RockeyyAbraham/Paaniguard/README.md

# PaaniGuard

ESP8266-based IoT water quality and usage monitoring system. Board target:
`esp8266:esp8266:nodemcuv2`. This firmware was built and compile-verified
with **no physical ESP8266 board attached** — see "What's stubbed pending
real hardware" and "Running without a board" below.

## File structure

| File | Purpose |
|---|---|
| `PaaniGuard.ino` | `setup()`/`loop()` only — wires the modules below together, no logic of its own |
| `config.h` | All pin definitions, WiFi placeholder credentials, thresholds, calibration constants |
| `sensors.h` / `.cpp` | Raw reads: pH & TDS (via ADS1115), DS18B20 temperature, flow pulse counting (ISR) |
| `drift_compensation.h` / `.cpp` | TDS temperature compensation + rolling-baseline drift correction, checkpoint persistence |
| `fingerprinting.h` / `.cpp` | Rule-based (non-ML) contamination pattern table and alert strings |
| `actuators.h` / `.cpp` | Relay/solenoid, buzzer, WS2812B status LED |
| `display.h` / `.cpp` | SSD1306 OLED rendering |
| `connectivity.h` / `.cpp` | WiFi station connect + SoftAP fallback |
| `webserver.h` / `.cpp` | Local status webpage (readings + active alert) |
| `cloud_logging.h` / `.cpp` | ThingSpeak push |
| `storage.h` / `.cpp` | LittleFS ring buffer of readings, survives reboot |
| `simulation.h` / `.cpp` | Synthetic sensor data for `SIMULATION_MODE` |
| `libraries.txt` | Libraries used by the production firmware |
| `wokwi/` | Experimental ESP32 target; production ESP8266 code is unchanged |

The production files live directly in this repo root because it is the Arduino
sketch folder itself (the `.ino` and its folder must share the containing
folder's name for the Arduino IDE to recognize it). `host_sim/` is a separate
native test harness, and `wokwi/` is a separate ESP32 experiment.

The older monolithic sketch is retained under `legacy/test.ino` so it remains
available for reference without being compiled as a second sketch. The former
root-level ESP32 Wokwi metadata is retained as
`legacy/experimental-root-diagram.json` and
`legacy/experimental-root-wokwi.toml`.
The production modules stay at the sketch root because Arduino IDE/CLI
compiles the root `.cpp` files automatically; moving them into `src/` would
require a different build layout and could break the existing Arduino flow.

The browser-based logic simulator lives in `virtual-simulation/`. It is a
separate software validation environment that mirrors source-defined behavior
without executing the ESP8266 firmware or claiming electrical validation. Open
`virtual-simulation/index.html` directly, or serve that folder with a static
HTTP server as described in its README.

## Pin map

Pins aren't locked to real hardware yet — this is a proposal, documented
here so it can be revisited once the board is on the bench.

| Signal | NodeMCU pin | GPIO | Why this pin |
|---|---|---|---|
| I2C SCL (ADS1115 + OLED) | D1 | GPIO5 | Standard ESP8266 Arduino core `Wire` default SCL |
| I2C SDA (ADS1115 + OLED) | D2 | GPIO4 | Standard ESP8266 Arduino core `Wire` default SDA |
| DS18B20 OneWire data | D6 | GPIO12 | No boot-time role; safe as a plain I/O from power-up |
| YF-S201 flow pulse (interrupt) | D5 | GPIO14 | Interrupt-capable and boot-safe; pulses can arrive before WiFi/cloud logic is up |
| Relay (solenoid valve) | D7 | GPIO13 | Plain output, no boot-time role; opto-isolation on the relay board protects the GPIO |
| WS2812B status LED data | D4 | GPIO2 | Requires HIGH at boot; its internal pull-up keeps it HIGH through boot since nothing writes to it until `setup()` runs |
| Buzzer | D0 | GPIO16 | No pull-up/interrupt support and normally reserved for deep-sleep wake (unused here); only ever written after `setup()` |
| *(unused, reserved)* | D3 | GPIO0 | Boot-sensitive (must read HIGH at boot) — left disconnected rather than risked |
| *(unused, reserved)* | D8 | GPIO15 | Boot-sensitive (must read LOW at boot) — left disconnected rather than risked |
| *(reserved)* | RX/TX | GPIO3/GPIO1 | Kept free for `Serial` — used for all debug/`SIMULATION_MODE` logging |
| *(intentionally unused)* | A0 | — | ESP8266's one onboard analog pin, only 10-bit — exactly why the ADS1115 is used instead (see below) |

**Why ADS1115 is mandatory:** the ESP8266 has exactly one analog input, at
10-bit resolution — not enough channels or precision for both pH and TDS.
The ADS1115 gives 4 channels at 16-bit over I2C, so pH is on ADS channel 0
and TDS is on ADS channel 1 (see `config.h`), with two channels spare.

## Libraries required

Install via `arduino-cli lib install`:

- Adafruit ADS1X15
- OneWire
- DallasTemperature
- Adafruit SSD1306
- Adafruit GFX Library
- Adafruit NeoPixel
- ThingSpeak
- (bundled with the `esp8266:esp8266` core: `ESP8266WiFi`, `ESP8266WebServer`, `LittleFS`)

**Cloud service: ThingSpeak**, not Blynk — a plain REST field-write needs no
persistent connection or companion app, and comfortably fits a
single-channel hobby/bench deployment. See `cloud_logging.cpp`.

## Opening / building this project

**Arduino IDE:** open `PaaniGuard.ino` directly. Install the ESP8266 board
package (board manager URL
`https://arduino.esp8266.com/stable/package_esp8266com_index.json`) and the
libraries above, then select board "NodeMCU 1.0 (ESP-12E Module)".

**arduino-cli**, run from the repo root:

```
arduino-cli config init
arduino-cli config add board_manager.additional_urls https://arduino.esp8266.com/stable/package_esp8266com_index.json
arduino-cli core update-index
arduino-cli core install esp8266:esp8266
arduino-cli lib install "Adafruit ADS1X15" "OneWire" "DallasTemperature" "Adafruit SSD1306" "Adafruit GFX Library" "Adafruit NeoPixel" "ThingSpeak"
arduino-cli compile --fqbn esp8266:esp8266:nodemcuv2 .
```

## Wokwi limitation

The production firmware is ESP8266-specific and remains unchanged. The
installed Wokwi VS Code extension (3.7.0) does not provide a usable
`wokwi-nodemcu-v2` or ESP8266 board model for `diagram.json`; the extension's
ESP8266 reference is for upload/debug tooling, not a Wokwi virtual board.
Therefore an exact Wokwi simulation of the production ESP8266 firmware is not
available in this environment. Do not treat an ESP32 diagram as an ESP8266
simulation and do not flash the ESP32 sketch to ESP8266 hardware.

The existing `wokwi/` directory is retained as a separate ESP32 compatibility
experiment only. It is not the production firmware, does not validate
ESP8266-specific behavior, and must not be used as evidence that the physical
ESP8266 build works. It preserves the production project's logical GPIO
numbers only to exercise generic peripheral behavior:

| Function | Production ESP8266 | Wokwi ESP32 GPIO |
|---|---|---:|
| DS18B20 | D6 / GPIO12 | GPIO12 |
| Flow pulse | D5 / GPIO14 | GPIO14 |
| Relay | D7 / GPIO13 | GPIO13 |
| WS2812B | D4 / GPIO2 | GPIO2 |
| Buzzer | D0 / GPIO16 | GPIO16 |
| OLED SDA | D2 / GPIO4 | GPIO4 |
| OLED SCL | D1 / GPIO5 | GPIO5 |

The compatibility experiment exercises generic DS18B20, flow input, relay,
buzzer, WS2812B, OLED, WiFi status page, drift compensation, and alert
behavior. TDS and pH remain simulated. It does not execute the root
`Paaniguard.ino` or its ESP8266 modules.

Install the ESP32 Arduino core once:

```
arduino-cli core install esp32:esp32
```

Build the virtual firmware artifact used by `wokwi/wokwi.toml` from the
repository root:

```
arduino-cli compile --fqbn esp32:esp32:esp32 --build-path wokwi/build --export-binaries wokwi
```

To run that compatibility experiment, open the `wokwi/` folder as the VS Code
workspace, open its `diagram.json`, and start Wokwi. This is optional and is
not a substitute for compiling and bench-testing the ESP8266 firmware. See
`wokwi/README.md` for the separation and exact commands.

For the real target, compile the root project with the ESP8266 board package,
then verify the physical wiring against the pin table above. The flow
pushbutton in the compatibility experiment is only a simulation substitute;
the physical device requires the flow sensor output to be divided down or
level-shifted before it reaches a GPIO — see "Electrical build notes" below.
An open-collector pull-up alone is not sufficient.

### Electrical build notes

See `BUILD.md` for the full step-by-step wiring sequence with test gates.

- The DS18B20 data line has the required 4.7 kOhm pull-up to 3.3 V.
- The physical YF-S201 flow output must never drive an ESP8266/ESP32 GPIO
  above 3.3 V. The YF-S201 needs 4.5 V minimum, so running it at 3.3 V to
  dodge the problem is out of spec and not an option. Power it from 5 V and
  drop the yellow signal line with a resistive divider: 1.8 kOhm in series
  from the sensor signal, then 3.3 kOhm from that junction to GND, with the
  junction going to GPIO14/D5. That gives ~3.24 V. A 10 kOhm / 20 kOhm pair
  also lands in range (3.33 V) but is higher impedance and gives a slower
  pulse edge. A dedicated level shifter is also valid. An external pull-up
  alone does NOT work: the sensor's own PCB already pulls the open-collector
  hall output up to its VCC rail, so the node still sits near 5 V (~3.7 V or
  more) and the GPIO still sees an over-voltage.
- The common 1-channel opto-isolated relay module is typically ACTIVE-LOW
  (IN pulled LOW energises the coil), which is the opposite of the
  active-HIGH assumption the firmware currently ships with. Measure the
  polarity on the actual board with a multimeter before the solenoid is
  plumbed (`BUILD.md`, BAG 6, Step 18). If it is active-LOW, swap
  `RELAY_LEVEL_VALVE_OPEN` and `RELAY_LEVEL_VALVE_CLOSED` in `config.h` —
  the drive levels are isolated there specifically so a polarity flip is a
  one-line change and never requires editing `actuators.cpp`.
- Feed the relay module's logic-side VCC from 3.3 V, not 5 V. At 5 V the IN
  pin becomes a 5 V node that a 3.3 V GPIO cannot drive cleanly, and it
  floats toward 4 V while the GPIO is high-impedance during boot/reset,
  back-feeding a pin that is not 5 V tolerant. If the board has a JD-VCC
  jumper, remove it and feed JD-VCC from 5 V so the coil still gets its
  rated voltage.
- The virtual relay module is only a logic simulation. For the physical
  solenoid, use a separately rated supply, an appropriately rated relay or
  MOSFET driver, a fuse, and flyback suppression. Do not power a 12 V valve
  from the microcontroller 3.3 V rail.
- Keep sensor/logic ground common at the controller. The physical relay's
  high-voltage or 12 V load wiring must remain isolated from the GPIO side.

**Re-verification pending.** The figures below were measured before the
drift-confidence API, the valve latch, and the WiFi reconnect path were added.
Those changes have not been compiled against the ESP8266 toolchain yet, because
`arduino-cli` is not installed in the environment they were written in. Re-run
the compile command above and update this paragraph with the real numbers
before citing them.

What *has* been verified since those changes: `host_sim` compiles the real
`drift_compensation.cpp` and `fingerprinting.cpp` with `g++ -Wall -Wextra` at
0 warnings, and its 7 assertions pass (see "Running without a board" below).
That covers the drift and fingerprinting logic only — not `actuators.cpp`,
`connectivity.cpp`, or the sketch itself.

Previously measured: 0 errors, 0 warnings in any PaaniGuard file, with
`--warnings all`. (The bundled ThingSpeak library itself emits 2 unused-
parameter warnings from its own header — not this project's code — when
`--warnings all` is used.) Flash size ~323KB/1MB (31%), IRAM ~61KB/65KB
(93%, mostly the ESP8266 core's own reserved instruction cache).

## Running without a board

No ESP8266 is attached to this project yet, so two separate things stand in
for "flash it and watch Serial":

**1. `SIMULATION_MODE` in the actual firmware.** `config.h` has
`#define SIMULATION_MODE 1`. With it on, `sensors.cpp` calls
`simulation.cpp` instead of touching real hardware, cycling through four
scenarios (6 sensor-read ticks each, ~30s at the default 5s interval):
clean water, a backdated rolling-baseline drift check, and two
contamination fingerprints (pH-drop+TDS-spike, and TDS-severe-alone). Every
tick prints one Serial line with pH, raw TDS, corrected TDS, temperature,
flow, and the fingerprinting decision (severity + shutoff y/n). This is
real firmware code and compiles/would run exactly this way once flashed —
it just can't be captured here without a board plugged in.

**2. `host_sim/` — a native test harness for right now.** Since there's no
board to flash, `host_sim/` compiles the *actual, unmodified*
`drift_compensation.cpp` and `fingerprinting.cpp` against two tiny
stand-in headers (`Arduino.h`, `LittleFS.h` — just enough surface for
`Serial`, `millis()`, and an in-memory LittleFS) and runs the same four
scenarios as a plain Windows executable, so the drift-correction and
fingerprinting logic can be inspected today. Build and run it with:

```
cd host_sim
g++ -std=gnu++14 -I. main.cpp shim_globals.cpp ../drift_compensation.cpp ../fingerprinting.cpp -o paaniguard_sim.exe
./paaniguard_sim.exe
```

Sample output (captured from this exact build):

```
=== Scenario 1: normal/clean water sample ===
[clean@25C       ] pH= 7.00  rawTDS=  310.0  tempC=25.0  ->  tempCompTDS=  310.0  ->  baselineCorrectedTDS=  310.0
                     severity=NONE     shutoff=no  alert="Water quality within normal parameters."
[clean@30C       ] pH= 7.00  rawTDS=  310.0  tempC=30.0  ->  tempCompTDS=  281.8  ->  baselineCorrectedTDS=  281.8
                     severity=NONE     shutoff=no  alert="Water quality within normal parameters."

=== Scenario 2: rolling-baseline drift correction ===
recording 4 backdated calibration checkpoints (probe dipped in 342ppm reference), simulating a week of fouling drift:
drift_compensation: recorded checkpoint day=20697 measuredPpm=345.00
drift_compensation: recorded checkpoint day=20699 measuredPpm=351.00
drift_compensation: recorded checkpoint day=20701 measuredPpm=358.00
drift_compensation: recorded checkpoint day=20703 measuredPpm=364.00
[post-drift-fit  ] pH= 7.00  rawTDS=  310.0  tempC=25.0  ->  tempCompTDS=  310.0  ->  baselineCorrectedTDS=  287.9
                     severity=NONE     shutoff=no  alert="Water quality within normal parameters."

=== Scenario 3: contamination pattern A (pH drop + TDS spike) ===
[contam-A        ] pH= 5.00  rawTDS= 1100.0  tempC=25.0  ->  tempCompTDS= 1100.0  ->  baselineCorrectedTDS= 1077.9
                     severity=SEVERE   shutoff=YES alert="Combined pH drop/spike with elevated TDS detected. Strong signature of chemical or industrial contamination. Water supply automatically shut off as a precaution."

=== Scenario 4: contamination pattern B (TDS severe spike alone, pH normal) ===
[contam-B        ] pH= 7.00  rawTDS= 1200.0  tempC=25.0  ->  tempCompTDS= 1200.0  ->  baselineCorrectedTDS= 1177.9
                     severity=SEVERE   shutoff=YES alert="Severe TDS spike detected, independent of pH. Possible heavy contamination event (e.g. industrial discharge, saltwater intrusion). Water supply automatically shut off as a precaution."
```

What this demonstrates:
- **Temperature compensation** (mechanism 1): `clean@30C` shows the same
  310ppm raw reading normalized down to 281.8ppm at a warmer temperature —
  the ~2%/°C rule in `drift_applyTemperatureCompensation()`.
- **Rolling-baseline drift correction** (mechanism 2, distinct from the
  above): after 4 backdated checkpoints showing the probe reading
  progressively higher than the 342ppm reference, the *same* 310ppm raw
  input that scenario 1 called "310.0, no correction" is now corrected down
  to 287.9ppm — `drift_applyBaselineCorrection()`'s linear fit predicting
  and subtracting the accumulated drift.
- **Fingerprinting**: two distinct SEVERE patterns (pH+TDS combined, and
  TDS alone) both correctly trigger `shutoff=YES` with their own
  pre-written alert text, while the clean and drift scenarios correctly
  stay at `NONE`.

`host_sim/` is a verification aid only — it is not compiled or referenced
by the actual sketch, and arduino-cli never sees it.

## What's stubbed pending real hardware

Every value below is a **PLACEHOLDER** (also marked `// PLACEHOLDER` /
`// TODO` at its definition in `config.h`) and must be replaced once the
real sensors and board are on the bench:

- **WiFi credentials** (`WIFI_SSID`, `WIFI_PASSWORD`) — dummy values.
- **ThingSpeak channel/key** (`THINGSPEAK_CHANNEL_ID`, `THINGSPEAK_WRITE_API_KEY`).
- **pH calibration** (`PH_CALIBRATION_SLOPE`, `PH_CALIBRATION_OFFSET`) —
  must be derived from real readings in pH 4.0 and 7.0 buffer solutions.
- **TDS calibration** (`TDS_CAL_COEFF_A/B/C`, `TDS_VREF`) — must be
  re-fit against the 342ppm reference solution on the real ADS1115 + TDS
  module; current values are textbook-typical starting points only.
- **Flow sensor pulses-per-liter** (`FLOW_PULSES_PER_LITER`) —
  datasheet-typical for the YF-S201, must be bench-measured with a
  known-volume container (unit-to-unit variance is common).
- **Safety thresholds** (`PH_SAFE_MIN/MAX`, `PH_SEVERE_LOW/HIGH`,
  `TDS_SAFE_MAX_PPM`, `TDS_SEVERE_MAX_PPM`) — WHO-typical starting points,
  not tuned to any specific local water supply.
- **Local authority contact** (`LOCAL_AUTHORITY_CONTACT`) — placeholder
  text only; the firmware never auto-dials or auto-texts anyone regardless
  of what this string says.
- **SSD1306/ADS1115 I2C addresses** — common defaults, confirm once the
  actual modules are wired up (some SSD1306 boards ship at `0x3D`).

## Design notes worth knowing about

- **Valve fail-safe:** `PIN_RELAY_VALVE` defaults LOW at boot (relay
  de-energized, valve closed) and only opens when explicitly commanded — an
  unexpected reset never leaves water flowing unsupervised.
- **Offline-first safety:** `fingerprint_evaluate()` and
  `actuators_applyFingerprint()` never touch the network — the shutoff/
  buzzer/LED response is identical whether WiFi is connected, in SoftAP
  fallback, or fully offline.
- **No RTC:** `drift_getCurrentDayIndex()` uses NTP epoch time once online
  (synced opportunistically by `connectivity.cpp`), and falls back to a
  flash-persisted uptime-based day counter when offline. Any power-off
  downtime is treated as instantaneous in that fallback — a known,
  documented approximation until/unless a real RTC is added.
- **Storage never blocks or fails:** `storage.cpp`'s ring buffer is
  preallocated on first boot; every append overwrites one fixed slot, so
  there's no filesystem growth and no "disk full" failure mode.
