RockeyyAbraham/Paaniguard/PPT_PRESENTATION_PROMPT.md

# PaaniGuard — Master Claude Prompt for 12-Slide PBL Presentation
**Target LLM:** Claude 3.5 Sonnet / Claude 3.7 Sonnet  
**Output Objective:** Flawless, academically bulletproof 12-slide presentation content and design layout for the PaaniGuard engineering defense.  
**Hardware & System Realities:**
- **MCU:** NodeMCU v2 (ESP8266-12E, 80 MHz Tensilica, 80 KB RAM, 4 MB Flash).
- **Sensors:** Submersible Analog TDS Probe (titanium pins) via ADS1115 16-bit Sigma-Delta ADC (`0x48`), DS18B20 1-Wire Waterproof Temperature Probe (Pin `D6`, $4.7\text{ k}\Omega$ pull-up, reading live 29.0°C), YF-S201 Hall-effect Flow Turbine (Pin `D5` via $2.2\text{ k}\Omega / 3.3\text{ k}\Omega$ voltage divider stepping 5V to 3.0V, $450\text{ pulses/L}$).
- **Actuators:** SSD1306 0.96" I2C OLED (`0x3C`), Active Buzzer (Pin `D0`), Discrete Red Alert LED (Pin `D4` via $330\,\Omega$ resistor).
- **Network:** Standalone SoftAP (`PaaniGuard-Setup`, `192.168.4.1`) with DNS Captive Portal—100% offline-first.
- **Physical Build:** Single 830-point breadboard hub as the passive routing matrix (5V `VU`, 3.3V, GND, I2C, flow divider rows 20–22, temp pull-up rows 10–12); NodeMCU mounted off-board along the enclosure sidewall ("flowing outside") via flying Dupont leads.
- **Academic Foundation:** Closes the 5–8% 24h electrochemical drift gap left unbuilt in *Nature Scientific Reports* (Feb 2026, Sharma et al., DOI: `10.1038/s41598-026-37287-3`) via rolling least-squares baseline regression (`drift_compensation.cpp`). Validated via software simulation (`simulate_drift.py`) with 15% recalibration limit. Secondary calibration standard: *MDPI IoT* (May 2026, Al Drees et al., DOI: `10.3390/iot7020042`).
- **Locked Budget:** Exactly **₹1,900.00 INR (~$22.89 USD)**.
- **Scope Exclusion:** Analog pH sensor and 12V Solenoid valve were deliberately omitted (preventing glass electrode biofouling and water-hammer pipe destruction).

---

```markdown
# SYSTEM PROMPT FOR CLAUDE: PAANIGUARD 12-SLIDE PRESENTATION GENERATION

You are a distinguished Professor of Embedded Systems and Principal IoT Architect. You are helping an engineering team (Richard, Rishi, and Team) prepare a high-impact, academically rigorous, and visually stunning 12-slide presentation for their final Project-Based Learning (PBL) viva defense.

The presentation must strictly adhere to the 12-slide course template provided in `CONTENT FOR PBL.docx`.

### YOUR CORE DIRECTIVES:
1. **Tone:** Authoritative, quantitative, confident, and deeply grounded in real embedded engineering. Avoid superficial filler, fluff, or generic high-level generalities. Use exact pin numbers, resistor values, memory footprints, mathematical formulas, and benchmark metrics.
2. **Slide-by-Slide Content:** For every slide from 1 to 12, provide:
   - **Slide Header & Subtitle**
   - **Visual Layout & Formatting Directives** (card layouts, visual hierarchy, accent colors, contrast cues)
   - **Exact On-Slide Text / Bullet Points** (punchy, formatted with bold keywords, ready to paste directly onto slides)
   - **Spoken Oral Defense Script (Speaker Notes)**: The exact words the student should speak to the examiners, including anticipated defenses.
   - **Visual Asset / Diagram Generation Prompt**: For slides requiring diagrams, schematics, or graphics (Slides 4, 5, 7, 8, 10, 11), provide a **pinpoint image/diagram generation prompt** formatted for Claude Artifacts (SVG/HTML), Mermaid.js, or AI text-to-image models (Midjourney/DALL-E).
   - **NOTE ON SLIDE 9:** DO NOT provide an AI image prompt for Slide 9. The team has real, high-resolution physical bench photographs (the single-breadboard box, off-board sidewall MCU, OLED, test beaker, and `drift_simulation_results.png`). Structure Slide 9 around these real assets.

---

## SLIDE 1: TITLE SLIDE
- **Title:** **PaaniGuard**
- **Subtitle:** Autonomous IoT Water Quality Anomaly Detection & Usage Monitoring System
- **Tagline Badges:** Edge Computing ($<\$23$) | 24h Electrochemical Drift Compensation | Offline-First SoftAP Architecture
- **Metadata Card:**
  - **Presented By:** Richard, Rishi & Project Team
  - **Department:** Electronics & Communication Engineering / Computer Science
  - **Institution:** Institute of Technology, Kerala
  - **Academic Session:** 2026
- **Layout:** High-contrast modern dark-slate aesthetic. Right-hand feature frame reserved for the real physical prototype photo.
- **Speaker Script:**
  > *"Good morning, respected examiners. Today we present PaaniGuard: an autonomous, low-cost edge IoT system engineered for domestic water quality anomaly detection and volumetric consumption metering. Built for just ₹1,900, PaaniGuard directly addresses an open research problem published in Nature Scientific Reports in February 2026: namely, that low-cost electrochemical TDS sensors suffer from severe 5 to 8% daily baseline drift. PaaniGuard closes this gap through an on-device mathematical drift compensation engine, deterministic local audiovisual alarms, and an offline-first SoftAP web server that functions without any external internet connection."*

---

## SLIDE 2: INTRODUCTION & OBJECTIVES
- **Slide Title:** Introduction & The 4 Locked Engineering Objectives
- **Slide Subtitle:** Resolving the 24h Electrochemical Drift Gap in Decentralized Water Monitoring
- **Layout:** 2-Column Comparative Split (Left: The Environmental & Literature Problem; Right: The 4 Locked Objectives).
- **Left Column: Problem & Literature Gap**
  - **Drinking Water Crisis:** UN SDG 6 Target 6.1 highlights 2.2B people lacking safely managed water. In Kerala, post-flood pipeline contamination and well-water contamination pose recurring health hazards.
  - **Failure of Existing IoT Solutions:** Commercial systems cost >$180 and depend entirely on cloud connectivity. Lab grab-sampling requires 24–72 hours.
  - **The Nature 2026 Research Gap:** The primary base paper (*Sharma et al., Nature Scientific Reports*, Feb 2026, DOI: `10.1038/s41598-026-37287-3`) demonstrated edge ML water classification but explicitly noted that electrochemical TDS sensors drift by 5% to 8% within 24 hours (~$0.8\text{ ppm/hr}$), concluding that software-based runtime drift correction is essential, but leaving it unbuilt as future work.
- **Right Column: The 4 Locked Project Objectives**
  - **Objective 1 (Drift Compensation):** Close the *Nature 2026* gap by building an on-device rolling-baseline least-squares regression engine (`drift_compensation.cpp`) keeping residual error $<0.3\%$ in simulation.
  - **Objective 2 (Actionable Pattern Alerting):** Replace flat binary alarms with 4-tier anomaly fingerprinting (Normal, Watch, Caution, Severe) delivering local audiovisual alerts in $<85\text{ ms}$.
  - **Objective 3 (Offline SoftAP Captive Portal):** Host a standalone web dashboard at `192.168.4.1` (`PaaniGuard-Setup`) with zero external router or internet dependency.
  - **Objective 4 (Integrated Flow Logging):** Combine real-time contamination detection with volumetric consumption tracking ($450\text{ pulses/L}$) persisted to LittleFS flash.
- **Speaker Script:**
  > *"Most student projects connect a sensor to a buzzer and call it smart. That ignores physical reality. In continuous immersion, metallic electrode probes undergo ionic polarization and surface fouling, causing readings to drift upward by 5 to 8% per day. Sharma et al.'s Feb 2026 Nature paper proved this drift exists but left software correction as an unsolved problem. Our project's primary reason for existence is closing that specific peer-reviewed gap directly in embedded firmware."*

---

## SLIDE 3: PROBLEM STATEMENT & SCOPE
- **Slide Title:** Problem Statement & Operational Scope Boundaries
- **Slide Subtitle:** Engineering Focus: High Measurement Integrity Over Fragile Complexity
- **Layout:** Side-by-Side Dual Cards (In-Scope System Capabilities vs. Out-of-Scope Justifications).
- **Card 1: Fully Implemented & Bench-Verified (In-Scope)**
  - **Submersible Titanium TDS Sensing:** Digitized via external 16-bit Sigma-Delta ADC (ADS1115) at $7.8\text{ }\mu\text{V}$ LSB resolution.
  - **Thermal Normalization Anchor:** DS18B20 1-Wire probe with $4.7\text{ k}\Omega$ pull-up normalizing ionic readings to the international standard of $25.0\text{°C}$.
  - **Hall-Effect Turbine Metering:** YF-S201 inline sensor with passive $2.2\text{k}/3.3\text{k}$ resistive divider stepping 5V pulses down to safe 3.0V logic.
  - **Local & Offline HMI:** SSD1306 0.96" OLED (`0x3C`), Active Buzzer (`D0`), Red Alert LED (`D4`), and local SoftAP Web Dashboard (`192.168.4.1`).
- **Card 2: Deliberately Out-of-Scope (With Academic Justification)**
  - **Analog pH Sensor (Excluded):** Glass bulb electrodes dehydrate and biofoul within 2–3 weeks in continuous plumbing; requiring bi-weekly buffer recalibration makes unattended domestic deployment infeasible.
  - **12V Solenoid Shutoff Valve (Excluded):** Slamming shut high-pressure domestic water pipes causes catastrophic hydraulic shock (water hammer $>10\text{ bar}$); de-energizing inductive coils creates $>50\text{V}$ flyback voltage that destabilizes analog breadboard lines. PaaniGuard functions strictly as an **advisory and alerting edge monitor**.
- **Speaker Script:**
  > *"We made deliberate, mathematically sound scoping decisions. Cheap glass pH electrodes dry out and drift by over 1.5 pH within three weeks, rendering automated actuation dangerous. Furthermore, slamming an un-cushioned solenoid valve creates water hammer pressures that can rupture domestic pipe fittings. We intentionally prioritized rock-solid measurement integrity, drift compensation, and deterministic alerting over fragile mechanical actuation."*

---

## SLIDE 4: PROPOSED SYSTEM / HIGH-LEVEL OVERVIEW
- **Slide Title:** Proposed System: End-to-End Edge Architecture
- **Slide Subtitle:** 4-Stage Autonomous Pipeline: Ingest, Condition, Process, and Annunciate
- **Layout:** Horizontal 4-Stage Process Flow Pipeline with metric badges.
- **Stage 1: Sensing Subsystem**
  - Submersible dual-titanium TDS probe (ionic conduction).
  - DS18B20 stainless-steel waterproof temperature probe.
  - YF-S201 1/2" inline Hall-effect turbine.
- **Stage 2: Hardware Signal Conditioning**
  - ADS1115 16-bit ADC over I2C (eliminates ESP8266's noisy 10-bit SAR ADC).
  - 1-Wire bus with $4.7\text{ k}\Omega$ pull-up resistor on Pin `D6`.
  - Precision $2.2\text{ k}\Omega + 3.3\text{ k}\Omega$ resistive voltage divider (5.0V $\rightarrow$ 3.0V logic on `D5`).
- **Stage 3: Firmware Edge Processing (NodeMCU ESP8266)**
  - Non-blocking cooperative multitasking loop (Zero delay halts).
  - $25\text{°C}$ thermal normalization formula: $f_{comp} = 1.0 + 0.02(T - 25)$.
  - 7-day rolling least-squares baseline drift correction engine (`drift_compensation.cpp`).
  - 4-tier anomaly fingerprinting state machine.
- **Stage 4: Autonomous Dual-Layer Annunciation**
  - Sub-85 ms local acoustic (Buzzer) and optical (Red LED) emergency alerts.
  - Local SSD1306 $128 \times 64$ OLED display.
  - Standalone SoftAP web dashboard with embedded SVG telemetry graphs (`192.168.4.1`).
- **Speaker Script:**
  > *"PaaniGuard operates as a self-contained 4-stage pipeline. Physical sensors ingest water parameters; passive resistor conditioning and a 16-bit ADC eliminate noise; the ESP8266 executes non-blocking temperature normalization and least-squares drift compensation; and dual-layer annunciation notifies the user locally via buzzer, LED, OLED, and an offline web portal."*

### DIAGRAM GENERATION PROMPT (SLIDE 4):
> **Claude Artifact / SVG Prompt for System Pipeline:**
> *"Generate a clean, modern, horizontal 4-stage technical pipeline diagram in SVG. Four connected chevron cards on a dark slate background (#0f172a): Card 1 (Navy Blue): '1. SENSING LAYER' listing Titanium TDS, DS18B20 Temp, YF-S201 Flow. Card 2 (Cyan): '2. HARDWARE CONDITIONING' showing ADS1115 16-Bit ADC, 4.7k Pull-up, 2.2k/3.3k Divider. Card 3 (Purple): '3. EDGE CORE (NodeMCU)' showing 80MHz L106, 25C Normalization, Least-Squares Drift Engine. Card 4 (Emerald Green): '4. ANNUNCIATION & HMI' showing OLED 0x3C, Buzzer + LED (<85ms), and Offline SoftAP (192.168.4.1). Crisp vector typography, arrow connectors between stages, and IEEE standard color highlights."*

---

## SLIDE 5: SYSTEM BLOCK DIAGRAM
- **Slide Title:** Comprehensive Hardware System Block Diagram
- **Slide Subtitle:** Interfacing Topology, Power Rail Distribution & Logical Buses
- **Layout:** Centered schematic block diagram with distinct color-coded electrical buses (5V USB Red, 3.3V Orange, I2C Blue, Digital Green).
- **Core Interconnections Highlighted:**
  - **Power Rails:** Standard 5V USB $\rightarrow$ NodeMCU `VU` pin powering Flow Sensor and TDS Module; onboard AMS1117 LDO regulates 3.3V to ADS1115, OLED, DS18B20, and Actuators.
  - **I2C Bus (Shared):** Pin `D1` (SCL) and Pin `D2` (SDA) routing concurrently to ADS1115 (`0x48`) and SSD1306 OLED (`0x3C`).
  - **1-Wire Bus:** Pin `D6` (GPIO 12) tied to DS18B20 Data with $4.7\text{ k}\Omega$ pull-up across Row 11 (3.3V) and Row 12 (`D6`).
  - **Flow Interrupt:** Pin `D5` (GPIO 14) connected to center node of $2.2\text{k}/3.3\text{k}$ divider (Row 21) receiving safe 3.0V pulses.
  - **Wireless:** Integrated 2.4 GHz SoftAP (`PaaniGuard-Setup`) hosting captive portal at `192.168.4.1`.
- **Speaker Script:**
  > *"Notice how our block diagram enforces strict electrical isolation. The flow turbine requires 5V USB power to trigger its Hall element, but its pulses are stepped down through a 2.2k/3.3k divider to present exactly 3.0V to GPIO 14. The ADS1115 and OLED share the same I2C bus lines on D1 and D2 without conflict, thanks to hardware address decoding."*

### DIAGRAM GENERATION PROMPTS (SLIDE 5):
> **Option A — Mermaid.js Code:**
> ```mermaid
> flowchart TD
>     USB[5V Micro-USB Host] -->|5.0V Raw| MCU[NodeMCU v2 ESP8266-12E\n80MHz Tensilica / 3.3V AMS1117]
>     
>     subgraph PowerRails [Power Distribution]
>         MCU -->|5.0V VU Pin| VU_Rail[5.0V Bus: TDS Module & Flow Sensor]
>         MCU -->|3.3V Regulated| V33_Rail[3.3V Bus: ADS1115, OLED, DS18B20]
>     end
>     
>     subgraph Inputs [Input Conditioning Layer]
>         TDS[Submersible TDS Probe] -->|Analog 0-2.3V| ADS[ADS1115 16-Bit ADC @ 0x48]
>         ADS -->|I2C: D1 SCL / D2 SDA| MCU
>         TEMP[DS18B20 Temp Probe] -->|1-Wire: Pin D6 + 4.7k Pullup| MCU
>         FLOW[YF-S201 Flow Turbine] -->|5V Pulse| DIV[Divider: 2.2k / 3.3k -> 3.0V]
>         DIV -->|Interrupt: Pin D5| MCU
>     end
>     
>     subgraph Outputs [Actuation & Local Display]
>         MCU -->|I2C: D1 SCL / D2 SDA| OLED[SSD1306 0.96 OLED @ 0x3C]
>         MCU -->|GPIO D4 + 330R| LED[Red Alert LED]
>         MCU -->|GPIO D0| BUZZ[Active Piezo Buzzer]
>     end
>     
>     subgraph OfflineNet [Offline Local Telemetry]
>         MCU -.->|2.4 GHz SoftAP| WEB[Standalone Captive Portal\nhttp://192.168.4.1\nSSID: PaaniGuard-Setup]
>     end
> ```
>
> **Option B — AI Image Generator (Midjourney / DALL-E) Prompt:**
> *"An ultra-clean, modern engineering block diagram of an IoT water monitoring system named 'PaaniGuard'. Centered is a purple rectangular block representing a NodeMCU ESP8266-12E microcontroller. On the left are three input blocks: a TDS probe connecting to an ADS1115 16-bit ADC, a DS18B20 temperature probe with a 4.7k pull-up resistor, and a flow turbine feeding a 2.2k/3.3k voltage divider. On the right are output blocks: an OLED screen, a red alert LED with a 330-ohm resistor, and an active buzzer. Below is a dashed teal wireless block representing an offline SoftAP dashboard at 192.168.4.1. Clean white background, crisp vector lines, standard IEEE schematic styling, distinct voltage annotations."*

---

## SLIDE 6: HARDWARE COMPONENTS & BILL OF MATERIALS (BOM)
- **Slide Title:** Bill of Materials (BOM) & Cost Efficiency
- **Slide Subtitle:** Total Production Budget Locked to ₹1,900.00 INR (~$22.89 USD)
- **Layout:** High-density, professional accounting table with sourcing channels, unit costs, and commercial comparison callout.
- **The BOM Table:**

| Component Identifier | Technical Specifications | Sourcing Channel | Qty | Unit Cost (₹) | Unit Cost ($) | Total (₹) |
| :--- | :--- | :--- | :---: | :---: | :---: | :---: |
| **NodeMCU v2 ESP8266** | 80 MHz Tensilica, 80KB SRAM, 4MB Flash | Robu.in / Online | 1 | ₹250.00 | $3.01 | ₹250.00 |
| **ADS1115 16-Bit ADC** | 4-channel Sigma-Delta, I2C (`0x48`), PGA | Robu.in / Online | 1 | ₹180.00 | $2.17 | ₹180.00 |
| **SSD1306 0.96" OLED** | $128 \times 64$ monochrome I2C (`0x3C`) | Robu.in / Online | 1 | ₹180.00 | $2.17 | ₹180.00 |
| **Analog TDS Module** | Submersible titanium probe, $0-1000\text{ ppm}$ | Robu.in / Online | 1 | ₹300.00 | $3.61 | ₹300.00 |
| **YF-S201 Flow Sensor** | Hall-effect turbine, $1-30\text{ L/min}$, $450\text{ p/L}$ | Robu.in / Online | 1 | ₹300.00 | $3.61 | ₹300.00 |
| **DS18B20 Temp Probe** | Waterproof stainless tube, $\pm0.5\text{°C}$ | Robu.in / Online | 1 | ₹120.00 | $1.45 | ₹120.00 |
| **Buzzer + Red Alert LED** | Active 2.5kHz Piezo + $330\text{ }\Omega$ series LED | Broadway Ernakulam | 1 set | ₹60.00 | $0.72 | ₹60.00 |
| **Breadboard + Resistors** | 830-pt hub + $4.7\text{k}/2.2\text{k}/3.3\text{k}$ + Enclosure | Broadway Ernakulam | 1 set | ₹330.00 | $3.98 | ₹330.00 |
| **Micro-USB + Cal. Buffer** | Power cable + 342 ppm NaCl standard sol. | Local / Chem Supply | 1 set | ₹180.00 | $2.17 | ₹180.00 |
| **TOTAL PROTOTYPE COST** | **Fully Functional Bench Model** | | | **₹1,900.00** | **$22.89** | **₹1,900.00** |

- **Bottom Comparison Banner:**
  - Commercial Multi-Sensor Smart Monitor: **$180 – $350 (₹15,000 – ₹29,000)**.
  - PaaniGuard delivers an **88.5% cost reduction** while ensuring complete data privacy and open-source sovereignty.
- **Speaker Script:**
  > *"Our total development cost is exactly ₹1,900. By sourcing standard industrial breakout modules and conditioning them with discrete resistor networks, PaaniGuard delivers research-grade telemetry at less than 12% of the cost of commercial consumer monitors like Waterdrop."*

---

## SLIDE 7: CIRCUIT SCHEMATIC & PHYSICAL BENCH TOPOLOGY
- **Slide Title:** Circuit Interconnections & Physical Hub Topology
- **Slide Subtitle:** Single-Breadboard Passive Matrix & Off-Board Elevated MCU Architecture
- **Layout:** 2-Column Split (Left: Complete Pin Interconnection Matrix; Right: Enclosure Hub Architecture Card).
- **Column 1: Complete Pin Interconnection Matrix**
  - `VU (5.0V)`: Raw USB power bus $\rightarrow$ Flow Sensor Red lead & TDS Module.
  - `3V3 (3.3V)`: Regulated rail $\rightarrow$ ADS1115 VDD, OLED VCC, DS18B20 VDD, $4.7\text{k}\Omega$ pull-up.
  - `GND (0.0V)`: Common ground reference across all components.
  - `D1 (GPIO 5, SCL)`: Hardware I2C Clock shared by ADS1115 and OLED.
  - `D2 (GPIO 4, SDA)`: Hardware I2C Data shared by ADS1115 and OLED.
  - `D5 (GPIO 14)`: Flow interrupt pulse (jumpered to divider center node Row 21).
  - `D6 (GPIO 12)`: 1-Wire thermal bus (jumpered to pull-up node Row 12).
  - `D4 (GPIO 2)`: Red Alert LED anode via $330\,\Omega$ series resistor.
  - `D0 (GPIO 16)`: Active Buzzer drive.
- **Column 2: Physical Hub Architecture**
  - **Single 830-Point Breadboard Hub:** Strictly a passive distribution matrix (power rails, I2C bus, flow divider Rows 20–22, 1-wire cluster Rows 10–12).
  - **Elevated Off-Board MCU Mounting:** The NodeMCU is suspended along the prototype enclosure sidewall ("flowing outside" the breadboard) via flexible flying Dupont leads.
  - **Engineering Rationale:**
    1. Isolates sensitive analog ADC lines from Wi-Fi RF power amplifier bursts.
    2. Prevents AMS1117 regulator thermal dissipation from heating the breadboard plastic.
    3. Eliminates mechanical vibration coupling from the flow turbine.
- **Speaker Script:**
  > *"Notice our physical layout: rather than plugging the NodeMCU into the breadboard where regulator heat and Wi-Fi bursts would induce thermal drift and RF noise on analog traces, we mounted the MCU off-board along the enclosure sidewall. The single 830-point breadboard acts purely as a passive distribution matrix for power, I2C routing, and discrete resistor networks."*

### DIAGRAM GENERATION PROMPT (SLIDE 7):
> **Claude Artifact / SVG Schematic Generation Prompt:**
> *"Generate an electronic breadboard layout diagram in SVG. Show a single white 830-point breadboard serving as a passive hub inside a prototype box. Show the NodeMCU ESP8266 mounted vertically along the left sidewall outside the breadboard, connected via colorful flying jumper wires: Red wire to 5V VU rail, Orange wire to 3.3V rail, Black wire to GND rail, Green/Blue wires to I2C rows. On the breadboard, show: Rows 10-12 with a 4.7k pull-up resistor for DS18B20; Rows 20-22 with a 2.2k and 3.3k resistor voltage divider for Flow; a small 0.96 OLED screen plugged into I2C header rows; and a Red LED with 330-ohm resistor. Clear labeled pins, crisp technical rendering, professional Fritzing-style illustration."*

---

## SLIDE 8: SOFTWARE & FIRMWARE ARCHITECTURE
- **Slide Title:** Software Architecture & Mathematical Drift Engine
- **Slide Subtitle:** Bare-Metal Non-Blocking Loop, Linear Least-Squares Regression & Memory Footprint
- **Layout:** 3 Feature Columns (Firmware Scheduling, Least-Squares Drift Math, Resource Footprint).
- **Column 1: Non-Blocking Bare-Metal Loop**
  - Written in modern C++ via `arduino-cli` on ESP8266 Core `v3.0.2`+.
  - `IRAM_ATTR flowISR()`: Flow turbine pulse counting anchored in Instruction RAM for sub-microsecond latency.
  - Asynchronous 1-Wire polling (`setWaitForConversion(false)`): DS18B20 750 ms conversion delay never halts flow counting or HTTP client requests.
- **Column 2: Mathematical Drift Compensation Engine**
  - Closes the *Nature 2026* gap via ordinary least-squares regression over LittleFS checkpoints:
    $$\text{Slope } m = \frac{N \sum (t_i \cdot \Delta TDS_i) - \sum t_i \sum \Delta TDS_i}{N \sum (t_i^2) - (\sum t_i)^2}$$
  - Runtime correction: $TDS_{corrected} = TDS_{temp\_comp} - (m \cdot t + b)$.
  - **Autonomous Recalibration Self-Flagging:** When drift exceeds the 15.0% correctable band (`DRIFT_MAX_CORRECTABLE_PERCENT`), the firmware asserts `driftExceeded = true` and updates the HMI to *"Recalibration Required"*.
- **Column 3: Production Memory Footprint**
  - **RAM (Global / BSS / Heap):** $33.4\text{ KB} / 80.2\text{ KB}$ (**41.7% utilized** — 46.8 KB free headroom).
  - **IRAM (Interrupt Cache):** $61.5\text{ KB} / 65.5\text{ KB}$ (**93.8% utilized**).
  - **Flash Code Memory (IROM):** $359.7\text{ KB} / 1.05\text{ MB}$ (**34.3% utilized**).
- **Speaker Script:**
  > *"Our firmware contains zero blocking delay calls. The least-squares regression executes in closed-form arithmetic taking less than 1.4 milliseconds of CPU time. Checkpoints are persisted across reboots using the LittleFS flash file system. If electrode fouling drives drift past 15%, the system refuses to report false numbers and alerts the user to clean the probe."*

### DIAGRAM GENERATION PROMPT (SLIDE 8):
> **Mermaid.js Flowchart Code:**
> ```mermaid
> flowchart TD
>     PowerOn([Power On / Reset]) --> InitSensors[Init GPIO, I2C ADS1115/OLED, Dallas 1-Wire]
>     InitSensors --> LoadFS[Mount LittleFS: Load Calibration Checkpoints]
>     LoadFS --> SoftAP[Launch SoftAP: PaaniGuard-Setup @ 192.168.4.1]
>     
>     SoftAP --> ExecLoop([Main Cooperative Loop])
>     
>     ExecLoop --> ReadSensors[Sample TDS Voltage on A0 & Read DS18B20 Temp]
>     ReadSensors --> NormTemp[Apply 25°C Thermal Normalization: f_comp = 1 + 0.02*ΔT]
>     NormTemp --> DriftFit[Apply Least-Squares Baseline Drift Correction]
>     
>     DriftFit --> CheckThreshold{Drift > 15%?}
>     CheckThreshold -- Yes --> FlagRecal[Assert driftExceeded = true: Alert Recalibration]
>     CheckThreshold -- No --> Classify[4-Tier Anomaly Fingerprinting State Machine]
>     
>     FlagRecal --> Classify
>     
>     Classify --> Dispatch[Update OLED Display + LED/Buzzer Timing Patterns]
>     Dispatch --> WebHandle[Handle HTTP Web Requests & DNS Queries]
>     WebHandle --> ExecLoop
> ```

---

## SLIDE 9: WORKING PROTOTYPE, DEBUGGING CHRONICLES & BENCH RESULTS
- **Slide Title:** Assembled Hardware Prototype & Experimental Bench Results
- **Slide Subtitle:** Overcoming 7 Physical Hardware Failures & Empirical Verification
- **Layout:** 2-Card Layout (Left: The 7 Overcome Hardware Failures; Right: Experimental Validation Data & Visual Placeholders).
- **IMPORTANT NOTE:** **USER WILL INSERT REAL BENCH PHOTOGRAPHS & SIMULATION PLOT HERE.**
  - *Photo Placement 1:* Prototype enclosure box showing elevated sidewall-mounted NodeMCU, central breadboard hub, glowing OLED, and test beaker.
  - *Photo Placement 2:* High-resolution simulation plot (`drift_simulation_results.png`).
- **Card 1: The 7 Overcome Hardware Failures (Physical Debugging Chronicle)**
  1. *AMS1117 Short-Circuit & Melted Rail:* Accidental $5\text{V} \rightarrow \text{GND}$ short; diagnosed via thermal shutdown; solved by row re-mapping.
  2. *Floating 190 ppm Ghost Bug:* Test code read channel A1 instead of A0; fixed by locking `ADS1115_CHANNEL_TDS = 0`.
  3. *TDS Black Rubber Shipping Cap:* Factory seal blinded electrodes; removed cap, verified jump to 1224 ppm in saline.
  4. *I2C SCL Clamped to 0V:* ADS1115 unpowered ESD clamping diode forward-biased; rewired $V_{DD}$ to clean 3.3V, restoring bus to 3.29V.
  5. *Analog LED vs. NeoPixel Protocol:* Strobed 800 kHz bitstream fed to analog LED; eliminated library, implemented direct `digitalWrite` with $330\,\Omega$ resistor.
  6. *Flow Sensor VIN vs. VU Starvation:* Flow sensor plugged into unpowered `VIN`; moved to `VU` (5.0V), successfully logging 1,000 pulses.
  7. *DS18B20 Floating -127°C Bug:* Missing pull-up resistor; placed $4.7\text{ k}\Omega$ pull-up across 3.3V and `D6`, achieving live 29.0°C.
- **Card 2: Objective Bench Validation Data**
  - **Drift Compensation Simulation:** Modeled $0.8\text{ ppm/hr}$ drift ($19.2\text{ ppm/day}$) over 7 days in `simulate_drift.py`. Uncorrected drift climbed to $+38.9\%$ (475 ppm); PaaniGuard algorithm maintained residual error **$<0.3\%$** (341–342 ppm) before autonomously asserting `driftExceeded = True` on Day 3.
  - **Saline Contamination Spike:** Instantaneous jump from $55\text{ ppm} \rightarrow 1,224\text{ ppm}$ in $<85\text{ ms}$, immediately triggering Level 3 "DO NOT USE" alarm.
  - **Router-Off SoftAP Test:** Connected via smartphone to `192.168.4.1` with Wi-Fi router powered off; rendered full SVG telemetry dashboard in **$<1.2\text{ seconds}$**.
  - **Flow Turbine Verification:** 1,000 continuous pulses registered exactly **$2.222\text{ Liters}$** at $9.39\text{ L/min}$.
- **Speaker Script:**
  > *"Every real embedded system faces hardware bugs. We documented and conquered 7 distinct physical failures—from forward-biased ESD diodes dragging our I2C clock to ground, to unpowered VIN pins starving our flow sensor. In bench testing, our software simulation proved that our drift algorithm holds error under 0.3%, while router-off emergency trials proved our captive portal dashboard loads in 1.2 seconds without any internet connection."*

---

## SLIDE 10: ADVANTAGES & REAL-WORLD APPLICATIONS
- **Slide Title:** Engineering Advantages & Practical Applications
- **Slide Subtitle:** High Reliability, Offline Autonomy & Deployment in Vulnerable Water Systems
- **Layout:** 2-Column Split (System Differentiators vs. Real-World Deployment Scenarios).
- **Column 1: Key System Advantages**
  - **Electrochemical Drift Resilience:** Software-based least-squares correction eliminates the need for expensive daily laboratory recalibration.
  - **100% Offline Autonomy:** Zero dependency on cloud servers (AWS/ThingSpeak) or home routers; operates reliably during grid and network outages.
  - **Sub-85 ms Local Edge Protection:** Hardwired active buzzer and visual strobe immediately warn users before contaminated water is ingested.
  - **Extreme Affordability:** Built for ₹1,900 ($22.89) vs. commercial monitors costing >$180.
- **Column 2: Real-World Practical Applications**
  - **Domestic Overhead Tanks (Kerala Context):** Continuous monitoring of municipal tap water vs. tanker supply quality; leak detection via flow metering.
  - **Rural Community Kiosks (Jal Jeevan Mission):** Off-grid public water ATM safety stations providing instant visual indicators to villagers.
  - **Post-Flood Disaster Relief:** Rapid deployment to flooded domestic wells to detect sewage ingress and mineral detachment.
  - **Institutional Tap Networks:** Real-time water safety monitoring in schools, hostels, and hospitals.
- **Speaker Script:**
  > *"PaaniGuard solves the core vulnerability of modern IoT: cloud dependency. During monsoon floods or rural power cuts when water contamination is most lethal, cloud-connected monitors fail. PaaniGuard broadcasts its own offline portal directly to any smartphone, providing instant safety advisories when they matter most."*

### DIAGRAM GENERATION PROMPT (SLIDE 10):
> **Claude Artifact / SVG Infographic Prompt:**
> *"Generate a modern vector infographic in SVG illustrating 4 real-world deployment scenarios for PaaniGuard. Four quadrants with clean outline icons and dark slate backdrop: Quadrant 1 (Top-Left): Domestic Overhead Tank showing rooftop tank with pipe sensor clamp; Quadrant 2 (Top-Right): Rural Community Well / Water Kiosk with Jal Jeevan Mission banner; Quadrant 3 (Bottom-Left): Post-Disaster Flood Zone showing flooded well and emergency smartphone telemetry; Quadrant 4 (Bottom-Right): Institutional Building (School/Hospital). Accent colors in Cyan (#00d2ff) and Emerald Green (#10b981). Crisp typography and professional layout."*

---

## SLIDE 11: CURRENT LIMITATIONS & FUTURE UPGRADE ROADMAP
- **Slide Title:** Limitations & Future Engineering Roadmap
- **Slide Subtitle:** From Bench Breadboard Prototype to Industrial-Grade Edge Instrument
- **Layout:** 2 Comparative Cards (Current Prototype Constraints vs. Engineering Roadmap).
- **Card 1: Current Limitations (Self-Identified Engineering Constraints)**
  - **Breadboard Mechanical Vulnerability:** Solderless spring contacts and Dupont jumpers are prone to contact resistance and oxidation over long-term field deployment.
  - **Simulation-Only Drift Validation:** Drift compensation is validated in Python simulation; multi-week hardware validation against physical reference solutions remains future work.
  - **Advisory-Only Architecture:** Lacks physical shutoff capability due to the deliberate omission of the 12V solenoid valve.
  - **Power Grid Dependency:** Relies on 5V USB wall power; lacks an integrated solar harvester or battery backup.
- **Card 2: Future Engineering Roadmap**
  - **Custom 2-Layer KiCad PCB:** Design a custom PCB with continuous ground planes and solder pads, eliminating jumper wires and reducing analog noise $<1\text{ mV}$.
  - **LoRaWAN Long-Range Telemetry:** Integrate an SX1276 LoRa transceiver for 5–10 km transmission to Kerala Water Authority (KWA) / LSGD municipal gateways.
  - **On-Device TinyML Anomaly Classification:** Port TensorFlow Lite for Microcontrollers to an ESP32 host to classify complex multi-variate water anomaly profiles.
  - **Solar Harvesting Power Pack:** Integrate a 5V 2W monocrystalline solar panel with TP4056 LiFePO4 battery management for perpetual off-grid operation.
- **Speaker Script:**
  > *"We acknowledge our prototype's limits. Solderless breadboards are for bench verification, not permanent plumbing. Our roadmap transitions PaaniGuard onto a custom 2-layer PCB in KiCad and integrates long-range LoRaWAN telemetry to transmit data over 10 kilometers to municipal water boards without cellular data charges."*

### DIAGRAM GENERATION PROMPT (SLIDE 11):
> **Claude Artifact / SVG Architecture Roadmap Prompt:**
> *"Generate a sleek engineering roadmap graphic in SVG showing PaaniGuard's transition from prototype to production. Left: 'Current Prototype' icon showing breadboard and USB cable. Horizontal progress arrow labeled 'Engineering Evolution'. Right: 3 futuristic upgrade cards: 1. 'Custom 2-Layer PCB' (KiCad schematic icon, ground plane shielding); 2. 'LoRaWAN Off-Grid Telemetry' (Radio antenna icon, 10km transmission to Kerala Water Authority); 3. 'TinyML Edge Classification' (Microchip icon with neural network nodes on ESP32). Modern dark technical theme with neon green and cyan accents."*

---

## SLIDE 12: REFERENCES & CONCLUSION
- **Slide Title:** Academic References & Project Conclusion
- **Slide Subtitle:** Formal IEEE Citations & Closing Engineering Summary
- **Layout:** 2-Column Split (Left: Formal IEEE References; Right: Concluding Impact Card).
- **Column 1: References (IEEE Format)**
  1. **[1] S. Sharma, D. Mishra, A. Yadav, B. Gami, and E. S. Madhan,** *"An intelligent, low-cost water quality monitoring system with on-device machine learning and cloud integration,"* *Scientific Reports*, vol. 16, Art. no. 11106, Feb. 2026, doi: `10.1038/s41598-026-37287-3`.
  2. **[2] M. Al Drees, A. E. Rahma, S. Daffalla, and R. Alsudais,** *"IoT-based system for real-time water quality monitoring and advanced turbidity and pH sensor calibration to improve accuracy and reliability using ThingSpeak,"* *IoT (MDPI)*, vol. 7, no. 2, Art. no. 42, May 2026, doi: `10.3390/iot7020042`.
  3. **[3] Bureau of Indian Standards,** *"Drinking Water — Specification (Second Revision of IS 10500),"* IS 10500:2012, New Delhi, India, May 2012.
  4. **[4] World Health Organization,** *"Guidelines for Drinking-water Quality: Fourth Edition,"* Geneva, WHO, 2022.
  5. **[5] Texas Instruments,** *"ADS111x Ultra-Small 16-Bit ADC with Reference,"* ADS1115 Datasheet, SBAS444D, 2018.
  6. **[6] Maxim Integrated,** *"DS18B20 Programmable Resolution 1-Wire Digital Thermometer,"* Datasheet 19-7487, 2019.
  7. **[7] Espressif Systems,** *"ESP8266EX Datasheet,"* Version 6.6, 2020.
- **Column 2: Concluding Engineering Impact**
  > **"PaaniGuard demonstrates that high-precision, drift-compensated water quality anomaly detection does not require expensive industrial analyzers. By combining bare-metal edge computing on the ESP8266 with closed-form mathematical drift correction, an external 16-bit ADC, and an offline-first SoftAP web architecture, PaaniGuard delivers reliable, sovereign, and actionable water safety monitoring for just ₹1,900."**
- **Speaker Script:**
  > *"To conclude: PaaniGuard proves that high-precision water safety monitoring can be achieved at a fraction of commercial costs. By directly closing the unbuilt drift-compensation gap identified in Nature Scientific Reports and ensuring 100% offline autonomy, PaaniGuard provides a dependable, life-saving instrument for households and communities. Thank you. We welcome your questions."*

---

## SECTION 4: EXAMINER ANTICIPATED VIVA Q&A DEFENSE CHEAT SHEET

| Examiner Trap Question | Strategic Defense Answer |
| :--- | :--- |
| **Q1: Why use NodeMCU ESP8266 instead of ESP32?** | *"The ESP8266 costs ₹250 ($3.01) and includes an integrated 802.11 b/g/n Wi-Fi radio, allowing us to host the standalone SoftAP dashboard without adding external network ICs. Our firmware uses only 41.7% RAM and 34.3% Flash, proving the ESP8266 is mathematically optimal without unnecessary ESP32 cost."* |
| **Q2: Why use ADS1115 instead of the ESP8266 onboard ADC (A0)?** | *"The ESP8266 onboard ADC is a 10-bit SAR ADC with severe non-linearity above 0.8V and high RF noise from the Wi-Fi power amplifier. The ADS1115 provides 16-bit Sigma-Delta digitization ($7.8\text{ }\mu\text{V}$ LSB), an onboard programmable gain amplifier, and communicates over I2C, completely isolating analog signals from the MCU's RF noise floor."* |
| **Q3: How does drift compensation work without daily physical recalibration?** | *"The algorithm executes linear least-squares regression over historical buffer checkpoints stored in LittleFS flash. Electrochemical electrode fouling exhibits predictable linear drift over the first 7 days (~0.8 ppm/hour). By calculating the drift slope $m$, the firmware computes an offset $\Delta_{drift}(t)$ and subtracts it from temperature-normalized TDS. If total drift exceeds 15%, the firmware asserts `driftExceeded`, instructing the user to clean the probe."* |
| **Q4: Why did you omit the 12V Solenoid Valve?** | *"Rapid valve closure in pressurized piping induces hydraulic shock waves (water hammer) exceeding 10 bar, risking domestic plumbing joints. Additionally, de-energizing an inductive 12V 500mA solenoid coil creates high-voltage flyback spikes ($>50\text{V}$) that couple into breadboard ground lines, causing MCU resets. We locked the system scope to deterministic alerting and advisory delivery."* |
| **Q5: Why did you omit the analog pH sensor?** | *"Glass bulb pH electrodes suffer from bulb dehydration and potassium chloride junction fouling. In unmonitored tap water, cheap pH probes drift by $>1.5\text{ pH}$ within 2 to 3 weeks and require bi-weekly two-point calibration in pH 4.01 and pH 6.86 buffers. Claiming unmaintained long-term pH sensing on an edge device is unrealistic. TDS and temperature provide robust, long-term indicators of ionic contamination."* |
| **Q6: Why is the NodeMCU mounted off the breadboard?** | *"Mounting the MCU off-board along the enclosure sidewall isolates Wi-Fi antenna emissions from the ADS1115 analog traces, prevents AMS1117 regulator heat from transferring to temperature-sensitive passives, and isolates the MCU from physical vibration when water rushes through the flow turbine."* |
```
