RockeyyAbraham/Paaniguard/MC 9 BAGS.docx

YES bro. This is exactly how we should do it. The BUILD.md is written like an engineering manual, but you're at the "I know how to put a jumper into a breadboard hole" level 😂, so I'm going to translate it into that level.

And we're not going to wire everything at once.

The manual itself says: finish one BAG → test it → only then move to the next BAG.

Also, because you decided to drop pH, we'll simply skip the pH part later. TDS stays.

🧠 First: understand what we're building

Your final hardware is basically:

WATER

│

▼

FLOW SENSOR

│

▼

TDS SENSOR

│

▼

TEMPERATURE

DS18B20

│

▼

┌──────────┐

│ ESP8266 │

│ NodeMCU │

└────┬─────┘

│

┌──────────┼───────────┐

▼ ▼ ▼

OLED Buzzer Relay

│

▼

12V SOLENOID

But we don't build this whole thing now.

🟢 BAG 0 — Make sure the NodeMCU works

Take out ONLY:

- NodeMCU
- Micro-USB cable
- ADS1115

First check that the ADS1115 header pins are actually soldered. If the pins are loose, stop there — they need soldering before we can use it.

Then:

NodeMCU → laptop

Laptop

│

Micro-USB cable

│

▼

NodeMCU

Nothing else connected.

Upload a simple Blink program.

Expected:

The onboard LED blinks.

If it doesn't, DO NOT TOUCH THE BREADBOARD YET.

That's Test Gate 0.

🟢 BAG 1 — Create your power rails

Now take:

- NodeMCU
- Breadboard #1
- 3 jumper wires

Put the NodeMCU across the centre gap of the breadboard.

Like:

breadboard

┌─────────────────────────────┐

│ │

│ ESP8266 │

│ ┌─────────┐ │

│ │ NodeMCU │ │

│ └─────────┘ │

│ │

└─────────────────────────────┘

The USB/antenna end should hang over the edge.

Now make THREE connections.

Connection 1

NodeMCU 3V3 → breadboard + rail

Use an orange wire.

Connection 2

NodeMCU G → breadboard − rail

Use black.

Connection 3

NodeMCU VIN → one ordinary breadboard row.

This row becomes our 5V ROW.

NODEMCU

3V3 ───────────────► + rail

G ───────────────► - rail

VIN ───────────────► spare row

The manual specifically defines these three rails this way.

🚨 STOP HERE

If you have a multimeter, measure:

3V3 rail → GND rail ≈ 3.3V

5V row → GND rail ≈ 4.5–5V

Don't continue until this is correct.

🟢 BAG 2 — ADS1115 + OLED

NOW we're going to make the famous SDA/SCL bus we were talking about.

Take:

- ADS1115
- OLED
- jumper wires

First ADS1115

Connect:

ADS1115 VDD ─────► 3.3V rail

ADS1115 GND ─────► GND rail

ADS1115 SCL ─────► D1

ADS1115 SDA ─────► D2

ADS1115 ADDR ────► GND rail

That's exactly what your build file specifies.

Why ADDR to GND?

Don't worry about the electronics theory yet.

Just remember:

ADDR gets connected to GND because your program expects the ADS1115 at address 0x48.

Then run the I²C scanner.

You should see:

0x48

That's Test Gate 2A.

NOW OLED

OLED has:

VCC

GND

SCL

SDA

Connect:

OLED VCC ─────► 3.3V rail

OLED GND ─────► GND rail

OLED SCL ─────► D1

OLED SDA ─────► D2

Notice something?

BOTH devices use D1/D2.

D1

│

┌───────────┴───────────┐

▼ ▼

ADS1115 SCL OLED SCL

D2

│

┌───────────┴───────────┐

▼ ▼

ADS1115 SDA OLED SDA

This is the 6-wire thing you asked about earlier.

And DO NOT ADD EXTRA I²C RESISTORS.

The manual explicitly says the OLED and ADS1115 breakout boards already have their bus pull-ups.

Run scanner again.

Now you should see:

0x48

0x3C

That's Test Gate 2B.

🟢 BAG 3 — DS18B20

NOW we finally use one of your resistors.

Take:

- DS18B20
- 4.7 kΩ resistor
- jumper wires

Your probe has three wires.

Put each wire into a different breadboard row.

Don't put all three into the same row.

The manual warns that wire colours can vary, so don't blindly trust red/black/yellow if yours are different.

For the standard wiring in the manual:

DS18B20 red ─────► 3.3V rail

DS18B20 black ───► GND rail

DS18B20 yellow ──► D6

NOW YOUR 4.7kΩ RESISTOR

This is the part you were confused about.

The resistor goes between the DATA row and the 3.3V rail.

NOT:

❌ resistor → GND

❌ resistor → D6 separately

❌ resistor → random breadboard hole

It is:

3.3V RAIL

│

[4.7kΩ]

│

├──────── DATA row

│ │

│ DS18B20

│ │

└──────────── D6

The manual explicitly says the resistor bridges the data row to the 3.3V rail.

Then test it with a temperature example.

You should get something like:

Temperature: 27°C

If you get:

-127°C

STOP. That's usually the DS18B20 data/pull-up wiring problem according to the manual.

🟢 BAG 4 — FLOW SENSOR

This one we do carefully.

Take:

- YF-S201
- 1.8 kΩ resistor
- 3.3 kΩ resistor

DO NOT connect the flow sensor directly to D5.

That's extremely important.

First build this:

1.8kΩ

Flow signal ─/\/\/\/───┬──────► D5

│

3.3kΩ

│

▼

GND

The manual specifically says build the divider before connecting it to D5.

Then test the divider.

The junction should measure around:

3.2 – 3.3 V

If it's above 3.4 V:

STOP. Don't connect D5.

Only after the divider passes:

divider junction ─────► D5

Then connect the actual YF-S201:

YF-S201 red ───────► 5V row

YF-S201 black ─────► GND rail

YF-S201 yellow ────► top of 1.8kΩ

Never directly to D5.

🟢 BAG 5 — BUZZER + LED

Now we add the little output indicators.

Buzzer

Buzzer VCC ─────► 3.3V

Buzzer GND ─────► GND

Buzzer I/O ─────► D0

WS2812B

Now another resistor!

This time it's the 330 Ω resistor.

D4

│

[330Ω]

│

▼

WS2812B DIN

And:

WS2812B VCC ───► 3.3V

WS2812B GND ───► GND

The manual specifies the LED at 3.3 V and R4 330 Ω on its data line.

There is also a 470 µF capacitor across the LED's VCC and GND:

3.3V ────────┬──── LED VCC

│

[470µF]

│

GND ─────────┴──── LED GND

The capacitor's negative/striped side goes to GND.

🟢 BAG 6 — RELAY + SOLENOID

🚨 This is where we slow down.

This is the highest-risk section according to your manual. It says to use Breadboard #2 and physically separate it from the sensor side.

First:

RELAY ONLY.

Do NOT connect the 12V adapter yet.

Relay VCC ─────► 3.3V rail

Relay GND ─────► GND rail

Relay IN ──────► D7

Then test the relay's COM/NO behaviour.

Only after we know the relay polarity do we touch the solenoid.

🔴 THEN — 12V SOLENOID

This is completely separate from the NodeMCU power.

12V adapter (+)

│

▼

RELAY COM

│

RELAY NO

│

▼

SOLENOID (+)

SOLENOID (-)

│

▼

12V adapter (-)

And the 1N4007 diode goes across the solenoid terminals:

Solenoid (+) ───────┐

│

|<| 1N4007

│

Solenoid (-) ───────┘

The banded end goes toward +.

VERY IMPORTANT

The manual explicitly says:

The 12V loop touches the NodeMCU nowhere.

And:

Do not connect the 12V ground to the NodeMCU GND rail.

So don't mix those grounds.

🟢 BAG 7 — Software

Only after all the hardware tests pass.

Then we install:

- ESP8266 board package
- required libraries
- configure Wi-Fi
- configure ThingSpeak
- run the actual firmware

The manual specifies a 2.4 GHz WPA2-Personal network for the ESP8266.

Don't worry about this yet.

🟢 BAG 8 — Make it reliable

Once everything works:

Breadboard prototype

↓

secure wires

↓

strain relief

↓

24-hour test

↓

continuous logging

The manual specifically says to secure cables and run a 24-hour bench test before beginning the longer drift run.

🟢 BAG 9 — TDS

And THIS is where your TDS finally gets added.

Since you've dropped pH, we simply don't build the pH module.

When you are ready for TDS:

TDS (-) ─────► GND

TDS (+) ─────► 3.3V

TDS (A) ─────► ADS1115 A1

The manual says the TDS output is 0–2.3 V and can go directly into the ADS1115 — no voltage divider needed.

🧠 YOUR RESISTORS — MEMORIZE THIS

This is probably the thing you were most worried about.

Resistor | Where it goes | Why
4.7 kΩ | DS18B20 DATA ↔ 3.3V | Temperature data pull-up
1.8 kΩ | Flow signal → divider junction | Flow voltage divider
3.3 kΩ | Divider junction → GND | Flow voltage divider
330 Ω | D4 → WS2812B DIN | LED data protection

These are explicitly listed in your build file.

And OLED/ADS1115 need no extra I²C resistors. BUILD.mdMD

🚨 THE MOST IMPORTANT THING FOR YOU RIGHT NOW

DO NOT START BAG 2, 3, 4, 5, 6 all together.

We're going to do:

Bag 0 → send me what you see → I tell you exactly what to plug → test → Bag 1 → test → Bag 2...

And I'll explain every resistor/wire at the "this leg goes into this breadboard row" level.

Your immediate job:

Only do BAG 0 right now.

1. Take NodeMCU.
2. Take Micro-USB cable.
3. Plug NodeMCU into PC.
4. Make sure the board is detected.
5. Run/upload Blink.
6. Confirm the onboard LED blinks.

Don't connect the breadboard or any sensor yet.

Once that works, send me a photo of your NodeMCU + breadboard, and we'll physically build BAG 1 together, one wire at a time.
