RockeyyAbraham/Paaniguard/docs/PBL_REPORT_PART2_IMPLEMENTATION_AND_RESULTS.md

# PaaniGuard — Project-Based Learning (PBL) Report Documentation
## PART 2: Implementation, Debugging Chronicles, Experimental Validation, and Cost Analysis
**Project Title:** PaaniGuard — Autonomous IoT Water Quality Anomaly Detection & Usage Monitoring System  
**Target Hardware Platform:** NodeMCU v2 (ESP8266-12E), ADS1115 16-bit I2C ADC, SSD1306 0.96" OLED, YF-S201 Flow Sensor, Analog Submersible TDS Sensor, DS18B20 1-Wire Waterproof Temperature Probe  
**Document Purpose:** Comprehensive, academically rigorous reference content for compiling the final project report in LaTeX and synthesizing presentation materials.

---

# CHAPTER 5: IMPLEMENTATION & PHYSICAL INTEGRATION

### 5.1 Physical Bench Implementation & Single-Breadboard Central Hub Topology
The actual physical prototype is constructed as a structured bench-test model housed inside a prototype enclosure box, featuring an **elevated/off-board microcontroller architecture** coupled with a **single 830-point solderless breadboard acting strictly as the centralized passive power and signal-routing hub**:

```
+-----------------------------------------------------------------------------------------+
| PHYSICAL BENCH PROTOTYPE ENCLOSURE BOX                                                  |
|                                                                                         |
|  [OFF-BOARD ELEVATED / CHASSIS PERIMETER MODULES]                                       |
|  - NodeMCU v2 (ESP8266-12E): Suspended/mounted along the enclosure sidewall ("flowing    |
|    outside" the breadboard). Connected entirely via flexible Dupont flying jumpers to   |
|    the breadboard rails and pins, preventing mechanical vibration, isolating Wi-Fi RF   |
|    emissions, and protecting the core MCU from localized regulator heating.             |
|  - TDS Signal Conditioning Board: Mounted on the enclosure sidewall/corner flap.        |
|  - ADS1115 16-Bit ADC & SSD1306 OLED: Interfaced via dedicated flying Dupont jumpers to  |
|    the breadboard's central I2C and power distribution rows.                            |
|                                                                                         |
|  [CENTRAL 830-POINT SOLDERLESS BREADBOARD HUB (PASSIVE ROUTING MATRIX)]                 |
|  - Power & Ground Distribution Rails:                                                   |
|    * Distributes 3.3V (from NodeMCU 3V3) to ADS1115, OLED, DS18B20 VDD, and R1 pullup.   |
|    * Distributes 5.0V (from NodeMCU VU) to TDS module and Flow sensor.                  |
|    * Distributes 0.0V common GND reference across all peripherals.                      |
|  - Shared I2C Communication Bus (D1 / D2 Header Rows):                                  |
|    * Distributes Pin D1 (GPIO 5, SCL) and Pin D2 (GPIO 4, SDA) to ADS1115 and OLED.     |
|  - Passive Level Shifter for Flow Turbine (Rows 20, 21, 22):                            |
|    * Row 20: Flow Yellow wire + R2 (2.2k)                                               |
|    * Row 21 (Center Node): R2 (2.2k) + R3 (3.3k) + Jumper to NodeMCU D5 (GPIO 14)       |
|    * Row 22: R3 (3.3k) + Jumper to GND rail                                             |
|  - 1-Wire Thermal Conditioning Strip (Rows 10, 11, 12):                                 |
|    * Row 10: DS18B20 Black (GND) + Jumper to GND rail                                   |
|    * Row 11: DS18B20 Red (3.3V) + Jumper to 3.3V rail + R1 (4.7k Pull-up Resistor)      |
|    * Row 12: DS18B20 Yellow (Data) + R1 (4.7k) + Jumper to NodeMCU D6 (GPIO 12)         |
|  - Actuators Connected to Breadboard:                                                   |
|    * Red Alert LED (Pin D4 via 330 Ohm resistor to GND)                                 |
|    * Active Buzzer Module (Pin D0 to GND)                                               |
|                                                                                         |
|  [SUBMERSIBLE & IN-LINE SENSORS ON BENCH]                                               |
|  - Fluid Test Beaker: Submersible TDS dual titanium probe & DS18B20 stainless probe.   |
|  - In-Line Conduit: YF-S201 1/2" turbine inline on bench, tethered via flying harness.   |
+-----------------------------------------------------------------------------------------+
```

#### Exact Pin-by-Pin Wiring Allocation:
1. **NodeMCU Flying Connections to Central Breadboard Hub:**
   - **`VU` (5V USB Out):** Connected directly to the breadboard 5V distribution block (powers TDS board and Flow sensor).
   - **`3V3` (Regulated 3.3V Out):** Connected to the breadboard 3.3V distribution rail (powers ADS1115, OLED, DS18B20, and R1 pull-up).
   - **`GND`:** Connected to the breadboard common ground rail.
   - **`D1` (GPIO 5, SCL) & `D2` (GPIO 4, SDA):** Routed to the breadboard I2C distribution rows to drive both ADS1115 (`0x48`) and OLED (`0x3C`).
   - **`D5` (GPIO 14, Flow Pulse):** Jumpered directly to the center node of the voltage divider (**Row 21**).
   - **`D6` (GPIO 12, OneWire):** Jumpered directly to the 1-Wire pull-up node (**Row 12**).
   - **`D4` (GPIO 2, LED):** Jumpered to the Red Alert LED anode via a $330\,\Omega$ series resistor.
   - **`D0` (GPIO 16, Buzzer):** Jumpered directly to the active buzzer positive pin.

---

### 5.2 Software Modules & Architecture Overview

The production firmware repository is organized into modular C++ subsystems compiled directly by `arduino-cli`:

| File Name | Functional Role in System | Key Algorithms / Responsibilities |
| :--- | :--- | :--- |
| `Paaniguard.ino` | Central Executive Loop | Non-blocking scheduling, cooperative delay loop, peripheral dispatching |
| `drift_compensation.cpp/.h` | Runtime Drift Engine | Linear least-squares regression, baseline subtraction, LittleFS checkpoint storage |
| `fingerprinting.cpp/.h` | Anomaly Classification | 4-tier severity state machine (Normal, Watch, Check, Do Not Use), advisory generation |
| `webserver.cpp` / `webpage.h` | Standalone Web HMI | HTTP web server, captive portal, JSON `/api/status`, embedded SVG dashboard |
| `connectivity.cpp/.h` | Network Management | Standalone SoftAP (`PaaniGuard-Setup`, `192.168.4.1`), auto-reconnect fallback |
| `actuators.cpp/.h` | Alert Dispatcher | Distinct temporal pulse patterns for LED and Buzzer (Level 2 vs Level 3 alarms) |
| `config.h` | System Configuration | Hardware pin assignments, threshold constants, calibration coefficients |

#### Memory Footprint (Production Build):
- **RAM (Global / BSS / Data):** $33,432\text{ bytes} / 80,192\text{ bytes}$ (**41.7% utilized**).
- **Instruction RAM (IRAM):** $61,495\text{ bytes} / 65,536\text{ bytes}$ (**93.8% utilized** — housing interrupt service routines).
- **Flash Code Memory (IROM):** $359,692\text{ bytes} / 1,048,576\text{ bytes}$ (**34.3% utilized**).

---

### 5.3 CHALLENGES FACED & PHYSICAL DEBUGGING CHRONICLES (THE FAILURE LOG)

Real-world hardware prototyping entails physical anomalies, thermal overloads, and electrical interface challenges. The following chronicle documents the 7 major physical failures encountered and overcome during the PaaniGuard build.

---

#### Case 1: The Breadboard Short-Circuit & AMS1117 Overheating Disaster
- **The Failure:** During early assembly of the flow sensor voltage divider, the ESP8266 suddenly reset. The onboard AMS1117 3.3V linear regulator rapidly heated past 125°C, scalding the builder's fingers, producing a sharp burning odor, and causing the breadboard power rail to melt and deform internally.
- **Root Cause Analysis:** Breadboards contain two separate contact topologies: continuous vertical power rails on the outer edges and horizontal 5-hole terminal rows in the middle. The builder mistakenly assumed middle columns were connected vertically, accidentally bridging the raw 5V (`VU`) USB line directly into the common Ground (`GND`) row. This created a dead short across the USB port, dumping over 1.5A into the breadboard clips and triggering the AMS1117 thermal shutdown.
- **Silicon Integrity Verification:** The board was immediately disconnected. After cooling, a verification sketch was flashed to toggle GPIO 4 and GPIO 5. Both pins switched cleanly between 0.00V and 3.28V, proving the ESP8266 silicon survived without gate destruction.
- **The Fix:** The charred, melted power rail was permanently decommissioned. Power and signal divider rows were strictly mapped into separate, numbered rows (Rows 20, 21, 22), physically separating 5V power from ground connections.

---

#### Case 2: The "Ghost 190 ppm" Floating ADC Channel Bug
- **The Failure:** When the analog TDS probe was tested completely dry in open air, the OLED screen displayed a stable reading of **190 ppm** (~0.52V) rather than 0 ppm.
- **Root Cause Analysis:** The test code read ADS1115 **Channel A1** (`ads.readADC_SingleEnded(1)`), but the physical sensor wire was seated in **Channel A0**. Because Channel A1 was floating with high input impedance ($>10\text{ M}\Omega$), ambient electromagnetic noise induced a 0.52V floating potential, which the polynomial equation calculated as 190 ppm.
- **The Fix:** Channel selection was corrected to Channel 0 (`ADS1115_CHANNEL_TDS = 0`). The floating reading disappeared, and dry baseline dropped to **0.000V (0 ppm)**.

---

#### Case 3: The Protective Black Shipping Cap on the TDS Probe
- **The Failure:** Dipping the TDS probe into fresh water resulted in an unvarying voltage of **0.000V (0 ppm)**. The sensor appeared entirely dead.
- **Root Cause Analysis:** Close visual inspection revealed that the probe tip was covered with an opaque black plastic factory shipping cap. This cap formed an airtight seal over the dual titanium pins, preventing any ionic water contact.
- **The Fix:** The shipping cap was removed, exposing the bare metal pins. Dipping the probe into a concentrated saline solution caused the voltage to jump to **2.411V (1224 ppm)**. Pulling it out into dry air returned it cleanly to **0.000V (0 ppm)**.

---

#### Case 4: The I2C Bus Lockdown (SCL Pulled Stuck to 0.00V)
- **The Failure:** Running an I2C scanner hung indefinitely. Probing pin `D1` (SCL) with a digital multimeter revealed it was pinned to **0.00V**.
- **Root Cause Analysis:** The ADS1115 $V_{DD}$ wire was still connected to the damaged, melted breadboard power rail from Case 1. CMOS ICs contain internal Electrostatic Discharge (ESD) clamping diodes between input pins and $V_{DD}$. Because the ADS1115 had zero supply voltage ($V_{DD} = 0\text{V}$), its internal ESD diode between SCL and $V_{DD}$ forward-biased, dragging the microcontroller's entire I2C clock line to Ground.
- **The Fix:** ADS1115 $V_{DD}$ was wired directly to the NodeMCU's clean `3V3` pin. The SCL line immediately rose to **3.29V**. The scanner was executed, and both **`0x48` (ADS1115)** and **`0x3C` (OLED)** were instantly acknowledged.

---

#### Case 5: 4-Pin Analog RGB LED vs. Digital WS2812B NeoPixel Protocol
- **The Failure:** The original schematic specified a WS2812B addressable LED. When a 4-pin RGB component was wired to `D4` with the Green and Blue pins left disconnected, the Red LED flickered dimly, accompanied by flickering of the NodeMCU onboard LED.
- **Root Cause Analysis:** The component was a **common-cathode analog RGB LED**, not a digital NeoPixel. The firmware was running the `Adafruit_NeoPixel` driver on `D4` (GPIO 2), sending high-speed 800 kHz bit-banged PWM serial pulses. The analog LED was being strobed with microsecond data pulses rather than steady DC voltage. Additionally, NodeMCU GPIO 2 is hardwired to the onboard blue LED (active LOW), causing it to strobe synchronously.
- **The Fix:** The NeoPixel library was eliminated. Pin `D4` was configured as a standard digital output with a $330\,\Omega$ series current-limiting resistor ($R_4$). Firmware was updated to use direct `digitalWrite`:
  - Normal / Clean water: Red LED driven `LOW` (OFF).
  - High TDS Contamination ($\ge 500\text{ ppm}$): Red LED driven `HIGH` (Solid / Rhythmic flash).

---

#### Case 6: Flow Sensor Power Starvation & NodeMCU `VIN` vs. `VU` Pin
- **The Failure:** The flow sensor was wired to the $2.2\text{k}\Omega / 3.3\text{k}\Omega$ divider, but blowing through the turbine resulted in `Pulses: 0` and `D5 = 0` permanently.
- **Root Cause Analysis:** The flow sensor Red wire was plugged into **`VIN`**. On NodeMCU v2 boards, `VIN` connects to the 5V USB line through a reverse-protection diode to prevent battery back-powering. When powered strictly through the micro-USB port, `VIN` carries **0.0V**! The YF-S201 Hall-effect sensor requires $\ge 4.5\text{V}$ to operate. Being unpowered, its output transistor stayed inactive, and the lower resistor $R_3$ pulled `D5` permanently down to Ground.
- **The Fix:** The flow sensor Red wire was moved to the **`VU` (VUSB) pin**, which provides direct 5.0V from the computer USB cable. The Hall IC immediately energized. Blowing through the nozzle registered pulses, climbing to **1,000 pulses** with live flow rates of $0.2 - 0.3\text{ L/min}$.

---

#### Case 7: DS18B20 1-Wire Bus Floating & Missing $4.7\text{ k}\Omega$ Pull-Up
- **The Failure:** When the DS18B20 temperature probe was first tested, the serial monitor and OLED reported: `Temp: DISCONNECTED (-127C)` and `D6 = 0`.
- **Root Cause Analysis:** The Dallas 1-Wire protocol relies on an open-drain bus architecture. When no device is asserting a zero, the bus MUST be pulled up to $3.3\text{V}$ by an external resistor. Because the pull-up resistor had not yet been inserted, pin `D6` floated at 0V. The Dallas library failed its initial presence-pulse handshake and returned `-127.0°C`.
- **The Fix:** A $4.7\text{ k}\Omega$ resistor ($R_1$) was inserted across **Row 11 (3.3V)** and **Row 12 (D6 Data)**. Pin `D6` flipped to `Logic 1` (3.3V), and the probe returned a stable room temperature reading of **30.2°C** (and subsequently **29.0°C**).

---

# CHAPTER 6: TESTING, RESULTS, AND PERFORMANCE ANALYSIS

### 6.1 Electrical Bench Measurements

| Test Point | Expected Voltage | Measured Voltage | Status | Engineering Observation |
| :--- | :--- | :--- | :--- | :--- |
| NodeMCU `VU` Pin | $5.00\text{V} \pm 5\%$ | **$4.98\text{V}$** | PASS | Sourced directly from USB host; powers TDS & Flow |
| NodeMCU `3V3` Pin | $3.30\text{V} \pm 2\%$ | **$3.29\text{V}$** | PASS | Stable AMS1117 LDO output; powers ADC, OLED, Temp |
| I2C Bus (`D1` SCL / `D2` SDA) | $3.30\text{V}$ (Idle HIGH) | **$3.28\text{V}$** | PASS | Held HIGH by breakout pull-ups; no bus contention |
| 1-Wire Bus (`D6` Idle) | $3.30\text{V}$ (Idle HIGH) | **$3.27\text{V}$** | PASS | Pulled up cleanly by $R_1 = 4.7\text{ k}\Omega$ |
| Flow Divider Node (`D5` Peak) | $3.00\text{V}$ | **$2.99\text{V}$** | PASS | $5.0\text{V} \times (3.3\text{k}/5.5\text{k}) = 3.0\text{V}$; completely safe for GPIO14 |
| Total Idle Power Draw | $< 100\text{ mA}$ | **$88.4\text{ mA}$** | PASS | All 3 sensors online, OLED on, SoftAP active |
| Total Alert Power Draw | $< 180\text{ mA}$ | **$142.1\text{ mA}$** | PASS | Buzzer sounding, Red LED on, Web client polling |

---

### 6.2 Experimental Validation of the 4 Project Objectives

#### 6.2.1 Objective 1 Validation: Runtime Drift Compensation (Software Simulation)
Because physical 7-day reference-solution testing was not feasible in the available time, the drift-correction algorithm was validated against a software simulation parameterized with the drift rate reported in the base paper (0.8 ppm/hr).

Following the protocol defined in the base paper [1] (Sharma et al.), electrochemical electrode drift was modeled over a 7-day period with an uncorrected baseline drift of $0.8\text{ ppm/hour}$ ($19.2\text{ ppm/day}$) on a $342.0\text{ ppm}$ standard NaCl reference solution, subject to Gaussian measurement noise ($\sigma = 0.8\text{ ppm}$). The firmware's rolling-baseline least-squares regression algorithm (`drift_compensation.cpp`, configured with `DRIFT_WINDOW_DAYS = 7` and `DRIFT_MAX_CORRECTABLE_PERCENT = 15.0`) was simulated day-by-day via `simulate_drift.py`:

| Day | True TDS (ppm) | Uncorrected TDS (ppm) | Sensor Drift (%) | Corrected TDS (ppm) | Residual Error (%) | Firmware Status / Action |
| :---: | :---: | :---: | :---: | :---: | :---: | :--- |
| 0 | 342.0 ppm | 342.4 ppm |  +0.1% | 342.4 ppm | 0.12% | Initial Baseline |
| 1 | 342.0 ppm | 361.7 ppm |  +5.8% | 341.3 ppm | 0.20% | Corrected (Active) |
| 2 | 342.0 ppm | 380.2 ppm | +11.2% | 341.5 ppm | 0.13% | Corrected (Active) |
| 3 | 342.0 ppm | 400.9 ppm | +17.2% | 342.8 ppm | 0.22% | RECALIBRATION REQUIRED |
| 4 | 342.0 ppm | 418.4 ppm | +22.3% | 341.1 ppm | 0.25% | RECALIBRATION REQUIRED |
| 5 | 342.0 ppm | 437.6 ppm | +28.0% | 341.6 ppm | 0.13% | RECALIBRATION REQUIRED |
| 6 | 342.0 ppm | 457.4 ppm | +33.7% | 342.9 ppm | 0.27% | RECALIBRATION REQUIRED |
| 7 | 342.0 ppm | 475.0 ppm | +38.9% | 341.4 ppm | 0.18% | RECALIBRATION REQUIRED |

*Outcome:* The least-squares baseline compensation in `drift_compensation.cpp` successfully maintained residual measurement error **below 0.3%** across the correctable operating window (Days 1–2). At Day 3 (accumulated drift $= 17.2\% > 15.0\%$), the system autonomously asserted the `driftExceeded = true` flag, commanding the OLED and web HMI to display *"Recalibration Required"* rather than reporting deceptively precise numbers. The full simulation script and graphical trajectory are archived in `simulate_drift.py` and `drift_simulation_results.png`.

#### 6.2.2 Objective 2 Validation: Actionable TDS-Pattern Alerting
Tested across controlled physical benchmarks:
- **Sharp Spike Signature (Contamination Anomaly):** Introducing NaCl saline buffer caused TDS to jump instantly from $55\text{ ppm} \rightarrow 1,224\text{ ppm}$ in $<85\text{ ms}$.
  - *HMI Verdict:* Level 3 (`DO NOT USE`).
  - *Action Advisory:* *"High TDS Spike detected. Do not consume. Contact Kerala Water Authority (KWA) / LSGD Health Officer."*
  - *Actuation:* Red LED blinking rapidly, active buzzer sounding double-beeps every second.
- **Normal / Clean Baseline:** Tested in municipal tap water ($54.9\text{ ppm}$, $29.0\text{°C}$).
  - *HMI Verdict:* Level 0 (`Water looks normal`).
  - *Actuation:* Red LED OFF, Buzzer silent.

#### 6.2.3 Objective 3 Validation: Offline-First Advisory Response (Router-Off Test)
- The local Wi-Fi router was physically powered OFF, disconnecting all external internet access.
- The ESP8266 initialized its standalone SoftAP: SSID **`PaaniGuard-Setup`**.
- A smartphone connected to `PaaniGuard-Setup`. The built-in DNS captive portal automatically routed the smartphone browser to **`http://192.168.4.1`**.
- *Result:* Full interactive telemetry dashboard, live SVG historical trend graphs, and plain-language health advisories rendered in **under 1.2 seconds** with zero external cloud dependencies.

#### 6.2.4 Objective 4 Validation: Integrated Volumetric Consumption Logging
Physical turbine pulse trials were performed using controlled airflow and water throughput:

| Trial | Duration ($\Delta t$) | Pulses Counted | Computed Flow Rate ($Q$) | Cumulative Volume Logged |
| :--- | :--- | :--- | :--- | :--- |
| **Trial 1 (Gentle Puff)** | $1.5\text{ s}$ | $22\text{ pulses}$ | **$1.95\text{ L/min}$** | $0.048\text{ Liters}$ |
| **Trial 2 (Continuous Run)**| $5.0\text{ s}$ | $113\text{ pulses}$ | **$3.01\text{ L/min}$** | $0.251\text{ Liters}$ |
| **Trial 3 (Burst Verification)**| $14.2\text{ s}$| **$1,000\text{ pulses}$** | **$9.39\text{ L/min}$** | **$2.222\text{ Liters}$** |
| **Trial 4 (Zero Flow / Still)**| Indefinite | $0\text{ pulses}$ | **$0.00\text{ L/min}$** | Latched total preserved |

*Verification:* Total volume is persisted to LittleFS flash memory every hour and across reboots, proving integrated consumption tracking.

---

# CHAPTER 7: COST ESTIMATION AND FINANCIAL ANALYSIS

### 7.1 Detailed Bill of Materials (BOM)

The prototype cost structure strictly matches the second-brain budget sheet:

| Component Description | Sourcing / Retail Channel | Quantity | Unit Cost (INR ₹) | Unit Cost (USD \$) | Total Cost (INR ₹) |
| :--- | :--- | :--- | :--- | :--- | :--- |
| NodeMCU v2 ESP8266-12E (CH340) | Robu.in / Online Electronics | 1 | ₹250.00 | \$3.01 | ₹250.00 |
| ADS1115 16-Bit Sigma-Delta ADC | Robu.in / Online Electronics | 1 | ₹180.00 | \$2.17 | ₹180.00 |
| SSD1306 0.96" I2C OLED Display | Robu.in / Online Electronics | 1 | ₹180.00 | \$2.17 | ₹180.00 |
| Analog Submersible TDS Sensor Probe | Robu.in / Online Electronics | 1 | ₹300.00 | \$3.61 | ₹300.00 |
| YF-S201 1/2" Water Flow Sensor | Robu.in / Online Electronics | 1 | ₹300.00 | \$3.61 | ₹300.00 |
| DS18B20 Waterproof Temperature Probe | Robu.in / Online Electronics | 1 | ₹120.00 | \$1.45 | ₹120.00 |
| Active Buzzer Module + Red Alert LED | Local Broadway Electronics (Ernakulam)| 1 set | ₹60.00 | \$0.72 | ₹60.00 |
| 1x 830-Point Breadboard + Resistors + Wires + Enclosure Box | Local Broadway Electronics (Ernakulam)| 1 set | ₹330.00 | \$3.98 | ₹330.00 |
| Micro-USB Cable + Connectors | Local Electronics | 1 set | ₹60.00 | \$0.72 | ₹60.00 |
| TDS Calibration Reference Solution (342 ppm)| Laboratory Chemical Supply | 1 bottle | ₹120.00 | \$1.45 | ₹120.00 |
| **TOTAL FINAL PROTOTYPE DEVELOPMENT COST** | | | **₹1,900.00** | **\$22.89** | **₹1,900.00** |

#### Sunk Cost & Scope Disclosure:
Earlier design phases evaluated an analog pH kit (₹550), pH buffer powders (₹150), a 12V solenoid valve (₹380), an opto-isolated relay (₹60), and a 12V 2A power adapter (₹180). These components were intentionally omitted from the final physical build to eliminate fragile glass electrode maintenance and avoid inductive relay switching noise on analog lines.

---

### 7.2 Total Development Cost vs. Commercial Alternatives

```
+----------------------------------------------------------------------------------------+
| System Category                        | Approx. Cost (USD) | Connectivity & Features  |
+----------------------------------------------------------------------------------------+
| Industrial Multi-Sensor Station (Hach) | $1,500 - $5,000    | Proprietary Modbus/SCADA |
| Commercial IoT Tap Monitor (Waterdrop) | $180 - $350        | App-locked, Cloud-only   |
| Benchtop Laboratory TDS/Conductivity   | $120 - $250        | Offline LCD, Manual Grab |
| PaaniGuard Open-Source Edge System     | $22.89 (₹1,900)    | Open I2C, SoftAP, Web HMI|
+----------------------------------------------------------------------------------------+
```

PaaniGuard achieves **over an 88% cost reduction** compared to commercial consumer smart water monitors while delivering complete data ownership and offline resilience.

---

# CHAPTER 8: CONCLUSION AND FUTURE SCOPE

### 8.1 Summary of Achievements
1. **Closing the Literature Drift Gap:** Successfully designed, coded, and demonstrated the unbuilt software drift compensation identified in the *Nature Scientific Reports* Feb 2026 paper [1] (Sharma et al.), keeping simulated residual TDS errors below 0.3% over the correctable operating window.
2. **Deterministic Edge Annunciation:** Integrated multi-tier audio-visual alarming (Active Buzzer + Discrete Red LED) with sub-85 ms local response time upon threshold violation.
3. **Offline SoftAP Captive Portal:** Delivered a standalone responsive web dashboard hosted on `192.168.4.1`, verified in router-off emergency testing.
4. **Resolved 7 Real-World Hardware Failures:** Overcame critical hardware faults (short-circuits, floating ADCs, ESD diode clamping, and power rail starvation) to build a thermally stable, level-shifted prototype.

### 8.2 Current Prototype Limitations
- **Simulation-Only Drift Validation:** Drift compensation is validated in simulation only; hardware validation against a physical reference solution over a multi-day period remains future work.
- **Breadboard Mechanical Reliability:** Solderless breadboard spring clips and Dupont jumpers are vulnerable to oxidation and mechanical shock over multi-month deployments.
- **Omission of Physical Actuation:** Automatic physical water cutoff via solenoid valve was excluded to ensure electrical safety; the system operates as an advisory and alerting node only.
- **Power Grid Dependency:** Relies on 5V USB mains power; lacks an integrated solar harvester or LiFePO4 battery uninterruptible power supply.

### 8.3 Recommendations and Future Upgrade Roadmap
1. **Printed Circuit Board (PCB) Fabrication:** Design a custom 2-layer PCB in KiCad with dedicated ground planes to permanently eliminate jumper wire resistance and reduce analog noise.
2. **LoRaWAN Off-Grid Telemetry:** Integrate an SX1276 LoRa transceiver for long-range, low-power telemetry to municipal water boards across 5–10 km distances in rural areas without cellular coverage.
3. **On-Device TinyML Anomaly Fingerprinting:** Port TensorFlow Lite for Microcontrollers to an ESP32 host to classify complex multi-variate water anomaly signatures (distinguishing between mineral scale detachment vs. chemical contamination).

---

# BIBLIOGRAPHY & REFERENCES (IEEE FORMAT)

1. **[1] S. Sharma, D. Mishra, A. Yadav, B. Gami, and E. S. Madhan,** *"An intelligent, low-cost water quality monitoring system with on-device machine learning and cloud integration,"* *Scientific Reports*, vol. 16, Art. no. 11106, Feb. 2026, doi: 10.1038/s41598-026-37287-3.
2. **[2] M. Al Drees, A. E. Rahma, S. Daffalla, and R. Alsudais,** *"IoT-based system for real-time water quality monitoring and advanced turbidity and pH sensor calibration to improve accuracy and reliability using ThingSpeak,"* *IoT (MDPI)*, vol. 7, no. 2, Art. no. 42, May 2026, doi: 10.3390/iot7020042.
3. **[3] Bureau of Indian Standards,** *"Drinking Water — Specification (Second Revision of IS 10500),"* IS 10500:2012, New Delhi, India, May 2012.
4. **[4] World Health Organization,** *"Guidelines for Drinking-water Quality: Fourth Edition Incorporating the First and Second Addenda,"* WHO Guidelines Approved by the Guidelines Review Committee, Geneva, World Health Organization, 2022.
5. **[5] Texas Instruments,** *"ADS111x Ultra-Small, Low-Power, 16-Bit Analog-to-Digital Converters with Internal Reference,"* ADS1115 Datasheet, SBAS444D, May 2009, Revised Jan. 2018.
6. **[6] Maxim Integrated,** *"DS18B20 Programmable Resolution 1-Wire Digital Thermometer,"* DS18B20 Datasheet, 19-7487, Rev. 6, 2019.
7. **[7] Espressif Systems,** *"ESP8266EX Datasheet,"* Version 6.6, Espressif Systems Inc., 2020.
8. **[8] Sea Industrial,** *"YF-S201 Water Flow Sensor Specification and Calibration Curves,"* Technical Application Note, 2018.
9. **[9] Solomon Systech,** *"SSD1306 128 x 64 Dot Matrix OLED/PLED Segment/Common Driver with Controller,"* SSD1306 Datasheet, Rev. 1.1, Apr. 2008.
10. **[10] P. Horowitz and W. Hill,** *The Art of Electronics*, 3rd ed. Cambridge, U.K.: Cambridge Univ. Press, 2015, pp. 415–430.
