RockeyyAbraham/Paaniguard/docs/drift_simulation_results.png

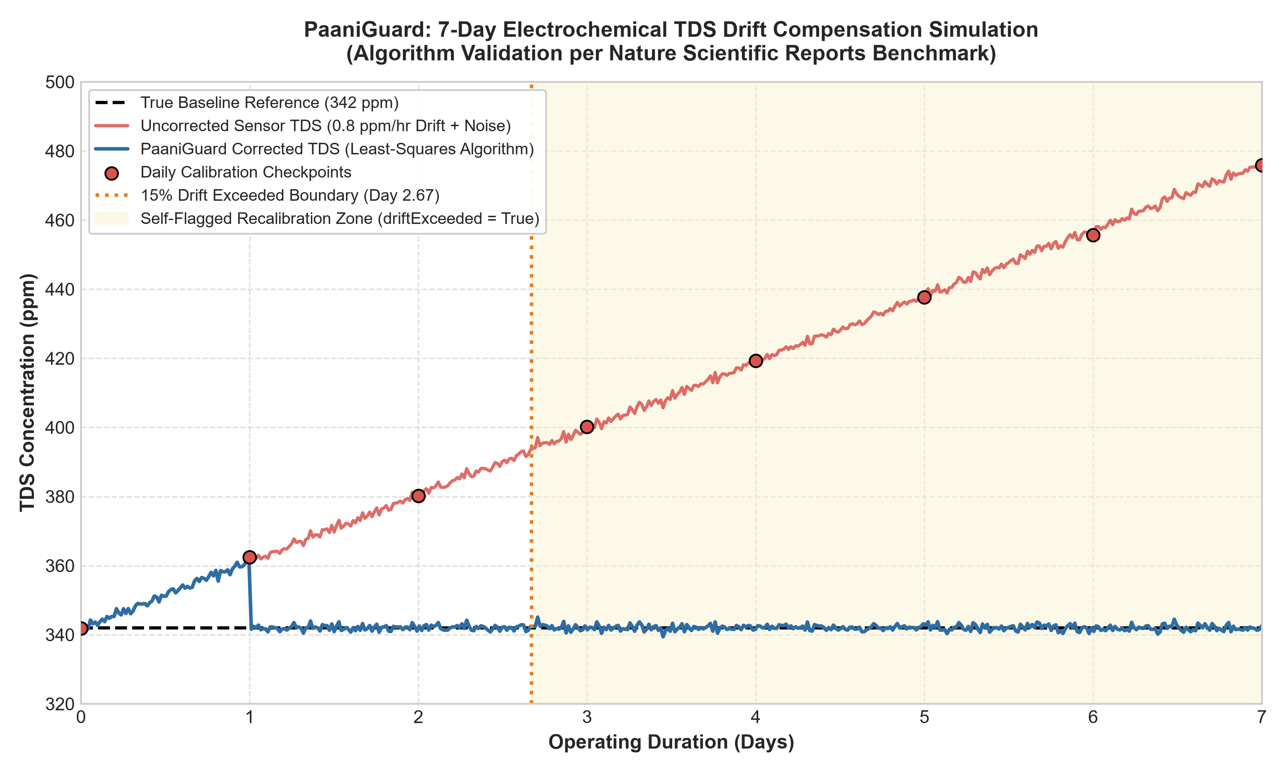
docs/drift_simulation_results.png
