RockeyyAbraham/Paaniguard/connectivity.h

// connectivity.h — WiFi station-mode connect with a SoftAP fallback.
// Station mode is tried first; if no known network is found within
// WIFI_CONNECT_TIMEOUT_MS, the device becomes its own access point at
// SOFTAP_SSID (default IP 192.168.4.1) so webserver.cpp always has
// something to serve on, online or not.

#ifndef PAANIGUARD_CONNECTIVITY_H
#define PAANIGUARD_CONNECTIVITY_H

#include <Arduino.h>
#include <IPAddress.h>

enum class ConnectivityMode { STATION, SOFTAP };

void connectivity_init();

// SoftAP only: skips station mode entirely and brings up the device's own
// network (SOFTAP_SSID / SOFTAP_PASSWORD at 192.168.4.1, up to 4 phones).
// For installs with no router, e.g. a tank. Use this instead of
// connectivity_init(), not alongside it.
void connectivity_startSoftAP();

ConnectivityMode connectivity_getMode();

// True only when in station mode AND actually associated — this is the
// gate cloud_logging.cpp uses to decide whether to push or skip silently.
bool connectivity_isOnline();

IPAddress connectivity_getIP();

// Call periodically from loop(). Once station mode has real NTP time, this
// corrects drift_compensation.cpp's offline day counter against it. No-op
// once synced, and no-op entirely in SoftAP mode (no internet to get NTP from).
void connectivity_maybeSyncTime();

// Call every loop(). Non-blocking: at most one WiFi.begin() per
// WIFI_RECONNECT_INTERVAL_MS, never waits for the result. Recovers a dropped
// station link, and promotes a booted-into-SoftAP device to station once the
// router comes back. The SoftAP is kept up on failed attempts so the local
// status page stays reachable.
void connectivity_maybeReconnect();

#endif // PAANIGUARD_CONNECTIVITY_H
