RockeyyAbraham/Paaniguard/host_sim/shim_globals.cpp

// shim_globals.cpp — defines the global instances declared extern in the
// Arduino.h / LittleFS.h host shims.

#include "Arduino.h"
#include "LittleFS.h"

SerialClass Serial;
LittleFSClass LittleFS;
