RockeyyAbraham/Paaniguard/(commit log)

2026-09-07 Add PaaniGuard skeleton and pin map config
    Sets up arduino-cli toolchain (esp8266:esp8266:nodemcuv2 core + all
    required libraries: Adafruit ADS1X15, OneWire, DallasTemperature,
    Adafruit SSD1306/GFX, Adafruit NeoPixel, ThingSpeak), proposes the full
    pin map with rationale for each pin, and lays down a minimal .ino that
    compiles clean against the target board. Every calibration/credential
    value in config.h is marked PLACEHOLDER pending real hardware.
    Claude-Session: https://claude.ai/code/session_01EivX7NwSoPBQMLwJTnQ5PM
2026-09-07 Add sensor reads and TDS drift compensation
    Implements sensors.cpp (pH/TDS via ADS1115, DS18B20 temp, interrupt-
    driven flow pulse counting) with a SIMULATION_MODE branch feeding
    synthetic values from a new minimal simulation.cpp. Adds
    drift_compensation.cpp with the two distinct TDS correction mechanisms:
    per-reading ~2%/C temperature normalization, and a separate rolling
    7-day baseline drift correction fit from calibration checkpoints
    persisted to LittleFS so the trend survives a reboot. Wires both into
    PaaniGuard.ino's loop for a compile-verified end-to-end check.
    Claude-Session: https://claude.ai/code/session_01EivX7NwSoPBQMLwJTnQ5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
    [drift_compensation.cpp, drift_compensation.h, sensors.cpp, sensors.h, simulation.cpp, simulation.h]
2026-09-07 Add contamination fingerprinting, actuator safety response, OLED display
    fingerprinting.cpp is a deterministic switch/lookup table over a small
    pH/TDS deviation bitmask (no ML) — covers isolated pH swings, isolated
    severe TDS spikes, and combined pH+TDS patterns, each mapped to a fixed
    plain-language alert string and a local-authority contact placeholder.
    It only returns a result; it never dials or messages anyone.
    actuators.cpp applies that result the same way regardless of WiFi
    state (offline-first): fail-safe-closed solenoid valve via relay,
    buzzer, and a WS2812B status color, with the valve/buzzer only engaged
    on Severity::SEVERE. display.cpp renders readings + the active alert
    to the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
    [actuators.cpp, actuators.h, display.cpp, display.h, fingerprinting.cpp, fingerprinting.h, sensors.cpp]
2026-09-07 Add WiFi connectivity, local webserver, ThingSpeak logging, ring-buffer storage
    connectivity.cpp tries station mode first and falls back to SoftAP
    (192.168.4.1) if no known network is found within
    WIFI_CONNECT_TIMEOUT_MS; it also opportunistically syncs NTP time once
    online and feeds it to drift_compensation's day-index tracking.
    webserver.cpp serves a small auto-refreshing status page (readings +
    active alert) identically in either connectivity mode. cloud_logging.cpp
    pushes to ThingSpeak (chosen over Blynk: plain REST field-write, no
    persistent connection or companion app needed) only when
    connectivity_isOnline(), and returns silently otherwise.
    storage.cpp is a fixed-layout LittleFS rin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
    [cloud_logging.cpp, cloud_logging.h, connectivity.cpp, connectivity.h, storage.cpp, storage.h, webserver.cpp, webserver.h]
2026-09-07 Add full simulation scenarios, host test harness, and README
    Expands simulation.cpp into a 4-scenario cycler (clean water, backdated
    rolling-baseline drift, and two distinct contamination fingerprints:
    pH-drop+TDS-spike, and TDS-severe-alone), driving the real firmware's
    sensor->drift->fingerprint->actuator chain end to end.
    Since no ESP8266 board is attached to this project, adds host_sim/: a
    native Windows test harness that compiles the actual, unmodified
    drift_compensation.cpp and fingerprinting.cpp against two small
    Arduino.h/LittleFS.h stand-in headers and runs the same scenarios as a
    plain executable, so the drift-correction and fingerprinting decisions
    can be inspected and verified t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
    [Arduino.h, LittleFS.h, drift_compensation.cpp, drift_compensation.h, main.cpp, sensors.cpp, shim_globals.cpp, simulation.cpp]
2026-09-07 Flatten sketch into repo root, merge duplicate README
    Moves every firmware file out of the redundant PaaniGuard/ subfolder
    (a repo named Paaniguard doesn't need a nested Paaniguard/ folder) so
    the repo root is directly the Arduino sketch. Renamed the .ino to
    Paaniguard.ino to match the repo folder's exact case, since Arduino
    requires the sketch folder and .ino filename to match.
    Merges the two READMEs into one at the repo root and fixes host_sim's
    relative include paths (../config.h etc, no more ../PaaniGuard/ prefix).
    Recompiled clean from the new location and reran host_sim with
    identical output.
    Claude-Session: https://claude.ai/co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
    [Paaniguard.ino, actuators.cpp, actuators.h, cloud_logging.cpp, cloud_logging.h, config.h, connectivity.cpp, connectivity.h]
2026-09-22 Add PaaniGuard build manual
    Adds the full PaaniGuard hardware build guide, including the parts list, ordered assembly sequence, validation gates, pin map, safety notes, and troubleshooting. This establishes the build workflow for the ESP8266-based water-quality monitor and documents the calibration and deployment steps needed before long-running operation.
2026-10-21 refactor: update hardware configuration, sensors, actuators, and display logic for physical deployment
2026-10-23 Add local status page, captive portal and OLED/page sync
    - web/index.html: responsive status page with Basic and Advanced views
    (verdict, TDS, flow, temperature slot, trend chart, sensor health),
    system fonts only so it works on the board's own offline WiFi.
    - webserver: serves the page from flash (webpage.h, generated by
    web/embed.py), adds /api/status and /api/history, DNS captive portal.
    - connectivity: connectivity_startSoftAP() for AP-only installs.
    - Paaniguard.ino: one fingerprint verdict drives buzzer, LED, OLED and
    page; OLED mirrors the page layout; join-WiFi screen only when no phone
    is connected (3 s every 15 s); simulated-data demo mode
    (DEMO_SENSOR_DATA, DEMO_HOLD_L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
2026-10-27 Wire TDS temperature and drift correction into the bench sketch
    - Paaniguard.ino: apply temperature compensation (when a temperature
    reading exists) then the rolling-baseline drift correction; the
    verdict, OLED, serial and page all use the corrected TDS. The drift
    flag now feeds fingerprint_evaluate, so the "recalibrate" advisory can
    surface as the Keep an eye on it level. Serial 'x' clears checkpoints.
    - drift_compensation: add drift_getCheckpointCount(), drift_hasTrend()
    and drift_clearCheckpoints().
    - webserver: POST /api/time (phone sends its clock; the board is AP-only
    and never gets NTP, so the drift trend would otherwise have no real
    days) and POST /api/calibrate (record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
2026-10-29 Show temperature probe as active and add as-measured TDS to the page
    - web/index.html: the temperature probe tag turns green when the probe
    responds, matching the TDS and flow tags. Advanced readings now list
    "TDS, as measured" next to "TDS, corrected", and note when no
    temperature correction is being applied.
    - webserver: /api/status tds block gains a raw field (the reading before
    temperature and drift correction).
    - web/serial_bridge.py: matching raw field (not carried over serial).
    - webpage.h regenerated from web/index.html.
    Verified: DS18B20 reads about 31.5 C on the board and /api/status reports
    it as ok; sketch compiles and was flashed. Rendered tag colour and the
    board's own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
